darklyght/RISC-V-on-Zynq-7000/spec/defines.tex

\newcommand{\currentSemester}{Fall 2019}
\newcommand{\projectSpecVersion}{4.3}

\newcommand{\dueDateTime}{end of lab sessions}

\newcommand{\blockDiagramTaskName}{Checkpoint 1}
\newcommand{\blockDiagramDueDate}{November 1}
\newcommand{\blockDiagramTimeAlloted}{1 week}

\newcommand{\baseCPUTaskName}{Checkpoint 2}
\newcommand{\baseCPUDueDate}{November 22}
\newcommand{\baseCPUTimeAlloted}{3 weeks}

\newcommand{\audioTaskName}{Checkpoint 3}
\newcommand{\audioDueDate}{December 9}
\newcommand{\audioTimeAlloted}{2 weeks}

\newcommand{\dfsTaskName}{Checkpoint 4}
\newcommand{\dfsDueDate}{December 6}
\newcommand{\dfsTimeAlloted}{2 weeks}

\newcommand{\finalCheckoffDueDate}{December 9 (by appointment)}

\newcommand{\finalReportDueDate}{December 11}

\newcommand{\skeletonRepoName}{project\_skeleton\_fa19}
\newcommand{\semesterName}{fa19}

%Also, change the info in minted blocks.  This includes the "Setting up your Code Repository" section and the "Setting up the Vivado Project" section
