darklyght/RISC-V-on-Zynq-7000/spec/project_spec.tex

\documentclass[11pt]{article}
\usepackage{fullpage}
\usepackage{verbatim}
\usepackage{moreverb}
\usepackage{amsmath}
\let\verbatiminput=\verbatimtabinput
\def\verbatimtabsize{4\relax}
\usepackage{tikz}
\usetikzlibrary{arrows,automata, positioning}
\usepackage{array}
\usepackage{booktabs}
\usepackage{minted}
\usepackage{parskip}
\usepackage{float}
\usepackage{pbox}
\usepackage{makecell}
\usepackage{gensymb}
\graphicspath{{images/}}

\usepackage{color}
\definecolor{rltred}{rgb}{0.75,0,0}
\definecolor{rltgreen}{rgb}{0,0.5,0}
\definecolor{rltblue}{rgb}{0,0,0.75}

\usepackage[%pdftex,
    colorlinks=true,
    urlcolor=rltblue,               % \href{...}{...}
    anchorcolor=rltbrightblue,
    filecolor=rltgreen,             % \href*{...}
    linkcolor=rltred,               % \ref{...} and \pageref{...}
    menucolor=webdarkblue,
    citecolor=webbrightgreen,
    pagebackref,
    pdfpagemode=UseNone,
    bookmarksopen=true]{hyperref}
\usepackage{graphicx}
\usepackage{hyperref}

\newcommand{\instbit}[1]{\mbox{\scriptsize #1}}
\newcommand{\instbitrange}[2]{~\instbit{#1} \hfill \instbit{#2}~}

\input{defines.tex}

\begin{document}
\begin{center}
{\bf
University of California at Berkeley \\
College of Engineering \\
Department of Electrical Engineering and Computer Science \\
}
\end{center}

\begin{center}
EECS151/251A - LB, \currentSemester
\end{center}

\begin{center}
\LARGE
{\bf Project Specification: RISCV151 }  \\
Version \projectSpecVersion
\end{center}

\tableofcontents

\newpage

\section{Introduction}
The goal of this project is to familiarize EECS151/251A students with the methods and tools of digital design.
In teams of 2, you will design and implement a 3-stage pipelined RISC-V CPU with a UART for tethering.
Afterwards, you will attach the IO circuits you built in the lab to the CPU and design a subtractive audio synthesizer.
Then, you will implement a simple dynamic frequency scaling algorithm to bound the power consumption and temperature of your FPGA design while achieving a performance target.
Finally, you will optimize your CPU for performance (maximizing the Iron Law) and cost (FPGA resource utilization).

You will use Verilog to implement this system, targeting the Xilinx Pynq platform (a Pynq-Z1 development board with a Zynq 7000-series FPGA).
The project will give you experience designing with RTL descriptions, resolving hazards in a simple pipeline, building interfaces, and teach you how to approach system-level optimization.

In tackling these challenges, your first step will be to map the high level specification to a design which can be translated into a hardware implementation.
After that, you will produce and debug that implementation.
These first steps can take significant time if you have not thought out your design prior to trying implementation.

As in previous semesters, your EECS151/251A project is probably the largest project you have faced so far here at Berkeley.
Good time management and good design organization is critical to your success.

\subsection{Tentative Deadlines}
\label{tentative_deadlines}
The following is a brief description of each checkpoint and approximately how many weeks will be alloted to each one. This schedule may change as the semester progresses. The current schedule is summarised at the end of the document in Section \ref{project_timeline}.

\begin{itemize}
  \item \textbf{\blockDiagramDueDate \space - \blockDiagramTaskName \space (\blockDiagramTimeAlloted)} - Draw a schematic of your processor's datapath and pipeline stages.
  \item \textbf{\baseCPUDueDate \space - \baseCPUTaskName \space (\baseCPUTimeAlloted)} - Implement your RISC-V processor core in Verilog and write tests to verify your implementation.
  \item \textbf{\audioDueDate \space - \audioTaskName \space (\audioTimeAlloted)} - Attach I/O components from lab to your processor (FIFOs, buttons, switches), general PWM controller, basic subtractive synthesizer
  %\item \textbf{\dfsDueDate \space - \dfsTaskName \space (\dfsTimeAlloted)} - Implement a dedicated power management unit to monitor FPGA temperature and power consumption and dynamically switch the operating frequency of the main CPU.
  \item \textbf{\finalCheckoffDueDate \space - Final Checkoff} - Final processor optimization and checkoff
  \item \textbf{\finalReportDueDate \space - Project Report} - Final report due
\end{itemize}

\subsection{General Project Tips}
\label{tips}
Document your project as you go.
You should comment your Verilog and keep your diagrams up to date.
Aside from the final project report (you will need to turn in a report documenting your project), you can use your design documents to help the debugging process.

Finish the required features first.
Attempt extra features after everything works well.
\textbf{If your submitted project does not work by the final deadline, you will not get any credit for any extra credit features you have implemented.}

This project, as has been done in past semesters, will be divided into checkpoints. The following sections will specify the objectives for each checkpoint.

\section{Checkpoints 1 \& 2 - 3-stage Pipelined RISC-V CPU}
The first checkpoint in this project is designed to guide the development of a three-stage pipelined RISC-V CPU that will be used as a base system in subsequent checkpoints.

\begin{figure}[hbt]
\begin{center}
  
  \caption{High-level overview of the full system}
  \label{fig:sys_overview}
\end{center}
\end{figure}

The green (RISC-V core) block on the diagram is the focus of the first and second checkpoints.
The third checkpoint will add audio and IO components in blue.
Finally, the fourth checkpoint will implement the power management unit in red.

\subsection{Setting up your Code Repository}
The project skeleton files are available on Github.
The suggested way for initializing your repository with the skeleton files is as follows:

\begin{minted}[tabsize=2]{bash}
  git clone git@github.com:EECS150/project_skeleton_fa19.git
  cd project_skeleton_fa19
  git remote add my-repo git@github.com:EECS150/fa19_teamXX.git
  git push my-repo master
\end{minted}

Then reclone your repo and add the skeleton repo as a remote:
\begin{minted}[tabsize=2]{bash}
  cd ..
  rm -rf project_skeleton_fa19
  git clone git@github.com:EECS150/fa19_teamXX.git
  cd fa19_teamXX
  git remote add staff git@github.com:EECS150/project_skeleton_fa19.git
\end{minted}

To pull project updates from the skeleton repo, run \verb|git pull staff master|.

To get a team repo, fill one line in the Google spreadsheet posted on Piazza with your team information (names, Github logins, and enrolled lab session).

You should check frequently for updates to the skeleton files.
Update announcements will be posted to Piazza.

\subsection{Integrate Designs from Labs} \label{past_designs}
You should copy some modules you designed from the labs.
We suggest you keep these with the provided source files in \verb|hardware/src| (overwriting any provided skeletons).

\begin{minted}[tabsize=2]{bash}
  cd fa19_teamXX
  cp fpga_labs_fa19/lab6/debouncer.v fa19_teamXX/hardware/src/io_circuits/.
\end{minted}

\textbf{Copy these files from the labs:}
\begin{minted}{bash}
  lab6/debouncer.v
  lab6/synchronizer.v
  lab6/edge_detector.v
  lab6/fifo.v
  lab6/uart_transmitter.v
\end{minted}

\subsection{Project Skeleton Overview}
\begin{itemize}
  \item \texttt{hardware}
    \begin{itemize}
      \item \texttt{src}
        \begin{itemize}
          \item \texttt{z1top.v}: Top level module. The RISC-V CPU is instantiated here.
          \item \texttt{PYNQ-Z1.xdc}: Constraints file. You can modify this to change pin assignments for peripherals when connecting I/O.
          \item \texttt{riscv\_core/Riscv151.v}: All of your CPU datapath and control should be contained in this file.
          \item \texttt{riscv\_core/reg\_file.v}: Your register file implementation.
          \item \verb|memories/{imem, dmem, bios_mem}.v|: Synthesizable RAMs for the instruction, data, and BIOS memories.
          \item \verb|io_circuits/uart.v, uart_transmitter.v, uart_receiver.v|: Your working UART from Labs 5 and 6
        \end{itemize}
      \item \texttt{sim}
        \begin{itemize}
          \item \verb|assembly_testbench.v|: Starting point for testing your CPU. Works with the software in \texttt{assembly\_tests}.
          \item \verb|echo_testbench.v|: Runs the software in \texttt{echo} on your CPU. The software implements the echo FSM from lab 5, and the testbench controls an off-chip UART to test it.
        \end{itemize}
    \end{itemize}
  \item \texttt{software}
    \begin{itemize}
      \item \verb|bios151v3|: The BIOS program, which allows us to interact with our CPU via the UART. You need to compile it before creating a bitstream or running a simulation.
      \item \verb|echo|: The echo program, which emulates the FSM from Lab 5 in software.
      \item \verb|assembly_tests|: Use this as a template to write assembly tests for your processor designed to run in simulation.
      \item \verb|c_example|: Use this as an example to write C programs.
      \item \verb|mmult|: This is a program to be run on the FPGA for Checkpoint 2. It generates 2 matrices and multiplies them. Then it returns a checksum to verify the correct result.
    \end{itemize}
\end{itemize}

To compile \texttt{software} go into a program directory and run \texttt{make}.
To build a bitstream run \texttt{make impl} in \texttt{hardware}.

\subsection{RISC-V 151 ISA}
Table \ref{tab:ISA} contains all of the instructions your processor is responsible for supporting.
It contains most of the instructions specified in the RV32I Base Instruction set, and allows us to maintain a relatively simple design while still being able to have a C compiler and write interesting programs to run on the processor.
For the specific details of each instruction, refer to sections 2.2 through 2.6 in the \href{http://riscv.org/specifications/}{RISC-V Instruction Set Manual}.

\subsubsection{CSR Instructions}
You will have to implement 2 CSR instructions to support running the standard RISC-V ISA test suite.
A CSR (or control status register) is some state that is stored independent of the register file and the memory.
While there are $2^{12}$ possible CSR addresses, you will only use one of them (\texttt{tohost = 0x51E}).
The \texttt{tohost} register is monitored by the RISC-V ISA testbench (\verb|isa_testbench.v|), and simulation ends when a non-zero value is written to this register.
A CSR value of 1 indicates success, and a value greater than 1 indicates which test failed.

There are 2 CSR related instructions that you will need to implement:
\begin{enumerate}
  \item \texttt{csrw tohost,x2}  (short for \texttt{csrrw x0,csr,rs1} where \texttt{csr = 0x51E})
  \item \texttt{csrwi tohost,1}  (short for \texttt{csrrwi x0,csr,uimm} where \texttt{csr = 0x51E})
\end{enumerate}

\texttt{csrw} will write the value from \texttt{rs1} into the addressed CSR.
\texttt{csrwi} will write the immediate (stored in the rs1 field in the instruction) into the addressed CSR.
Note that you do not need to write to \texttt{rd} (writing to x0 does nothing), since the CSR instructions are only used in simulation.

\input{isa.tex}

\subsection{Pipelining}
Your CPU must implement this instruction set using a 3-stage pipeline.
The division of the datapath into three stages is left unspecified as it is an important design decision with significant performance implications.
We recommend that you begin the design process by considering which elements of the datapath are synchronous and in what order they need to be placed.
After determining the design blocks that require a clock edge, consider where to place asynchronous blocks to minimise the critical path.
The RAMs we are using for the data, instruction, and BIOS memories are both synchronous read \textbf{and} write.

\subsection{Hazards}
As you have learned in lecture, pipelines create hazards.
Your design will have to resolve both control and data hazards.
You must resolve data hazards by implementing forwarding whenever possible.
This means that you must forward data from your data memory instead of stalling your pipeline or injecting NOPs.
All data hazards can be resolved by forwarding in a three-stage pipeline.

You'll have to deal with the following types of hazards:
\begin{enumerate}
  \item \textbf{Read-after-write data hazards} Consider carefully how to handle instructions that depend on a preceding load instruction, as well as those that depend on a previous arithmetic instruction.
  \item \textbf{Control hazards} What do you do when you encounter a branch instruction, a jal (jump and link), or jalr (jump from register and link)?
    You will have to choose whether to predict branches as taken or not taken by default and kill instructions that weren't supposed to execute if needed.
    You can begin by resolving branches by stalling the pipeline, and when your processor is functional, move to naive branch prediction.
\end{enumerate}

\subsection{Register File}
\label{reg_file}
Your register file should have two asynchronous-read ports and one synchronous-write port (positive edge).

To test your register file, you should write a testbench to verify the following:
\begin{itemize}
  \item Register 0 is not writable, i.e. reading from register 0 always returns 0
  \item Registers are updated on the same cycle that a write occurs (i.e. the value read on the cycle following the rising edge of the write should be the value written).
  \item The write enable signal to the register file controls whether a write occurs (\verb|we| is active high, meaning you only write when \verb|we| is high)
  \item Reads should be asynchronous (the value at the output one simulation timestep (\#1) after feeding in an input address should be the value stored in that register)
\end{itemize}

\subsection{RAMs}
\label{ram_info}
In this project, we will be using inferred block RAMs to implement memories for the processor.

\subsubsection{Initialization}
The Verilog \verb|$readmemb(filename, path to 2D reg, start addr, end addr)| and \verb|$readmemh()| system tasks can be used to initialize a 2D reg with a text file containing the desired contents of the memory (in binary or hex respectively).
These system tasks are placed inside an \verb|initial| block and point to a particular 2D reg instance to initialize.
If a 2D reg isn't initialized it is filled with Xs.

For synthesis, the BIOS memory is initialized with the contents of the BIOS program, and the other memories are left uninitialized (zeroed out)\\
(see \verb|src/memories/{imem, dmem, bios_mem}.v|).

For simulation, the provided testbenches initialize the BIOS memory with a program specified by the testbench (see \verb|sim/assembly_testbench.v|).

\subsubsection{Endianness + Addressing}
The instruction and data RAMs have 16384 32-bit rows, as such, they accept 14 bit addresses.
The RAMs are \textbf{word-addressed}; this means that every unique 14 bit address refers to one 32-bit row (word) of memory.

However, the memory addressing scheme of RISC-V is \textbf{byte-addressed}.
This means that every unique 32 bit address the processor computes (in the ALU) points to one 8-bit byte of memory.

We consider the bottom 16 bits of the computed address (from the ALU) when accessing the RAMs.
The top 14 bits are the word address (for indexing into one row of the block RAM), and the bottom two are the byte offset (for indexing to a particular byte in a 32 bit row).

\label{endianness}
\begin{figure}[H]
  \begin{center}
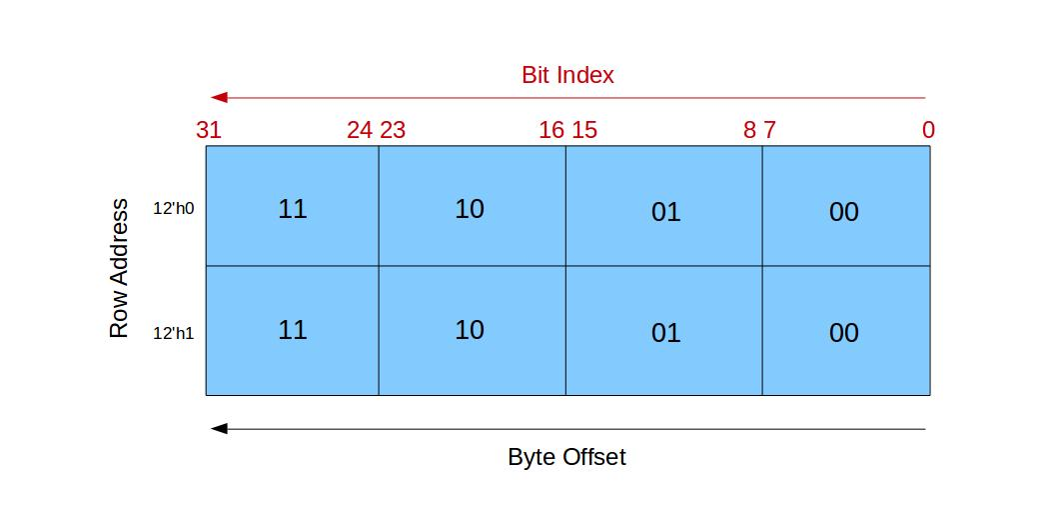
[picture p1: spec/images/endianness_img.jpg]
    
    \caption{Block RAM organization. The labels for row address \textbf{should read 14'h0 and 14'h1.}}
    \label{fig:endianness_img}
  \end{center}
\end{figure}

Figure \ref{fig:endianness_img} illustrates the 14-bit word addresses and the two bit byte offsets.
Observe that the RAM organization is \textbf{little-endian}, i.e. the most significant byte is at the most significant memory address (offset '11').

\subsubsection{Reading from RAMs}
Since the RAMs have 32-bit rows, you can only read data out of the RAM 32-bits at a time.
This is an issue when executing an \verb|lh| or \verb|lb| instruction, as there is no way to indicate which 8 or 16 of the 32 bits you want to read out.

Therefore, you will have to shift and mask the output of the RAM to select the appropriate portion of the 32-bits you read out.
For example, if you want to execute a \verb|lbu| on a byte address ending in \verb|2'b10|, you will only want bits \verb|[23:16]| of the 32 bits that you read out of the RAM (thus storing \verb|{24'b0, output[23:16]}| to a register).

\subsubsection{Writing to RAMs}
To take care of \verb|sb| and \verb|sh|, note that the \verb|we| input to the instruction and data memories is 4 bits wide.
These 4 bits are a byte mask telling the RAM which of the 4 bytes to actually write to.
If \verb|we|=\{4'b1111\}, then all 32 bits passed into the RAM would be written to the address given.

Here's an example of storing a single byte:
\begin{itemize}
  \item Write the byte \verb|0xa4| to address \verb|0x10000002| (byte offset = 2)
  \item Set \verb|we = {4'b0100}|
  \item Set \verb|din = {32'hxx_a4_xx_xx}| (\verb|x| means don't care)
\end{itemize}

\subsection{Memory Architecture}
The standard RISC pipeline is usually depicted with separate instruction and data memories.
Although this is an intuitive representation, it does not let us modify the instruction memory to run new programs.
Your CPU, by the end of this checkpoint, will be able to receive compiled RISC-V binaries though the UART, store them into instruction memory, then jump to the downloaded program.
To facilitate this, we will adopt a modified memory architecture shown in Figure \ref{fig:mem_arch}.

\begin{figure}[hbt]
  \begin{center}
    
    \caption{The Riscv151 memory architecture. There is only 1 IMEM and DMEM instance in Riscv151 but their ports are shown separately in this figure for clarity. The left half of the figure shows the instruction fetch logic and the right half shows the memory load/store logic.}
    \label{fig:mem_arch}
  \end{center}
\end{figure}

\subsubsection{Summary of Memory Access Patterns}
The memory architecture will consist of three RAMs (instruction, data, and BIOS).
The RAMs are memory resources (block RAMs) contained within the FPGA chip, and no external (off-chip, DRAM) memory will be used for this project.

The processor will begin execution from the BIOS memory, which will be initialized with the BIOS program (in \verb|software/bios151v3|).
The BIOS program should be able to read from the BIOS memory (to fetch static data and instructions), and read and write the instruction and data memories.
This allows the BIOS program to receive user programs over the UART from the host PC and load them into instruction memory.

You can then instruct the BIOS program to jump to an instruction memory address, which begins execution of the program that you loaded.
At any time, you can press the reset button on the board to return your processor to the BIOS program.

\subsubsection{Unaligned Memory Accesses}
In the official RISC-V specification, unaligned loads and stores are supported.
However, in your project, you can ignore instructions that request an unaligned access.
Assume that the compiler will never generate unaligned accesses.

\subsubsection{Address Space Partitioning}
Your CPU will need to be able to access multiple sources for data as well as control the destination of store instructions.
In order to do this, we will partition the 32-bit address space into four regions: data memory read and writes, instruction memory writes, BIOS memory reads, and memory-mapped I/O.
This will be encoded in the top nibble (4 bits) of the memory address generated in load and store operations, as shown in Table \ref{mem_space1}.
In other words, the target memory/device of a load or store instruction is dependent on the address.
The reset signal should reset the PC to the value defined by the parameter \verb|RESET_PC| which is by default the base of BIOS memory (\verb|0x40000000|).

\begin{table}[hbt]
  \begin{center}
    \caption{Memory Address Partitions}
    \label{mem_space1}
    \begin{tabular}{l l l l l}
      \bottomrule
      \textbf{Address[31:28]} & \textbf{Address Type} & \textbf{Device} & \textbf{Access} & \textbf{Notes} \\
      \midrule
      4'b00x1 & Data & Data Memory & Read/Write &\\
      4'b0001 & PC  &  Instruction Memory & Read-only &\\
      4'b001x & Data & Instruction Memory & Write-Only & Only if PC[30] == 1'b1\\
      4'b0100 & PC  & BIOS Memory & Read-only &\\
      4'b0100 & Data & BIOS Memory & Read-only &\\
      4'b1000 & Data & I/O & Read/Write &\\
      \bottomrule
    \end{tabular}
  \end{center}
\end{table}

Each partition specified in Table \ref{mem_space1} should be enabled based on its associated bit in the address encoding.
This allows operations to be applied to multiple devices simultaneously, which will be used to maintain memory consistency between the data and instruction memory.

For example, a store to an address beginning with \verb|0x3| will write to both the instruction memory and data memory, while storing to addresses beginning with \verb|0x2| or \verb|0x1| will write to only the instruction or data memory, respectively.
For details about the BIOS and how to run programs on your CPU, see Section~\ref{bios_info}.

Please note that a given address could refer to a different memory depending on which address type it is.
For example the address \verb|0x10000000| refers to the data memory when it is a data address while a program counter value of \verb|0x10000000| refers to the instruction memory.

The note in the table above (referencing PC[30]), specifies that you can only write to instruction memory if you are currently executing in BIOS memory.
This prevents programs from being self-modifying, which would drastically complicate your processor.

\subsubsection{Memory Mapped I/O}
\label{mmio}
At this stage in the project the only way to interact with your CPU is through the UART.
The UART from Lab 5 accomplishes the low-level task of sending and receiving bits from the serial lines, but you will need a way for your CPU to send and receive bytes to and from the UART.
To accomplish this, we will use memory-mapped I/O, a technique in which registers of I/O devices are assigned memory addresses.
This enables load and store instructions to access the I/O devices as if they were memory.

To determine CPI (cycles per instruction) for a given program, the I/O memory map is also used to include instruction and cycle counters.

Table~\ref{mem_map1} shows the memory map for this stage of the project.

\begin{table}[hbt]
  \begin{center}
    \caption{I/O Memory Map}
    \label{mem_map1}
    \begin{tabular}{l l l l}
      \toprule
      \textbf{Address} & \textbf{Function} & \textbf{Access} & \textbf{Data Encoding}\\
      \midrule
      \verb|32'h80000000| & UART control & Read & \verb|{30'b0, data_out_valid, data_in_ready}| \\
      \verb|32'h80000004| & UART receiver data & Read & \verb|{24'b0, data_out}| \\
      \verb|32'h80000008| & UART transmitter data & Write & \verb|{24'b0, data_in}| \\
      \midrule
      \verb|32'h80000010| & Cycle counter & Read & Clock cycles elapsed \\
      \verb|32'h80000014| & Instruction counter & Read & Number of instructions executed \\
      \verb|32'h80000018| & Reset counters to 0 & Write & N/A \\
      \bottomrule
    \end{tabular}
  \end{center}
\end{table}

You will need to determine how to translate the memory map into the proper ready-valid handshake signals for the UART.
Your UART should respond to \verb|sw, sh, and sb| for the transmitter data address, and should also respond to \verb|lw, lh, lb, lhu, and lbu| for the receiver data and control addresses.

You should treat I/O such as the UART just as you would treat the data memory.
This means that you should assert the equivalent write enable (i.e. valid) and data signals at the end of the execute stage, and read in data during the memory stage.
The CPU itself should not check the \verb|data_out_valid| and \verb|data_in_ready| signals; this check is handled in software.
The CPU needs to drive \verb|data_out_ready| and \verb|data_in_valid| correctly.

The cycle counter should be incremented every cycle, and the instruction counter should be incremented for every instruction that is committed (you should not count bubbles injected into the pipeline or instructions run during a branch mispredict).
From these counts, the CPI of the processor can be determined for a given benchmark program.

\subsection{Testing}
\label{testing}
The design specified for this project is a complex system and debugging can be very difficult without tests that increase visibility of certain areas of the design.
In assigning partial credit at the end for incomplete projects, we will look at testing as an indicator of progress.
A reasonable order in which to complete your testing is as follows:

\begin{enumerate}
  \item Test that your modules work in isolation via Verilog testbenches
  \item Test the entire CPU one instruction at a time with hand-written assembly --- see \verb|assembly_testbench.v|
  \item Test the CPU's memory mapped I/O --- see \verb|echo_testbench.v|
  \item Run the \verb|riscv-tests| ISA test suite
\end{enumerate}

\subsubsection{Integration Testing}
Once you are confident that the individual components of your processor are working in isolation, you will want to test the entire processor as a whole. The easiest way to do this is to write an assembly program that tests all of the instructions in your ISA.
A skeleton is provided for you in \verb|software/assembly_tests|.
See Section \ref{assembly_tests} for details.

Once you have verified that all the instructions in the ISA are working correctly, you may also want to verify that the memory mapped I/O and instruction/data memory reading/writing work with a similar assembly program.

\subsection{Software Toolchain - Writing RISC-V Programs}
\label{toolchain}
A GCC RISC-V toolchain has been built and installed in the eecs151 home directory; these binaries will run on any of the c125m machines in the 125 Cory lab.
The most relevant programs in the toolchain are:
\begin{itemize}
    \item \verb|riscv64-unknown-elf-gcc|: GCC for RISC-V, compiles C code to RISC-V binaries.
    \item \verb|riscv64-unknown-elf-as|: RISC-V assembler, compiles assembly code to RISC-V binaries.
    \item \verb|riscv64-unknown-elf-objdump|: Dumps RISC-V binaries as readable assembly code.
\end{itemize}

Look at the \verb|software/c_example| folder for an example of a C program.

There are several files:
\begin{itemize}
    \item \verb|start.s|: This is an assembly file that contains the start of the program.
      It initialises the stack pointer then jumps to the \verb|main| label.
      Edit this file to move the top of the stack.
      Typically your stack pointer is set to the top of the data memory address space, so that the stack has enough room to grow downwards.

    \item \verb|c_example.ld|: This linker script sets the base address of the program.
      For Checkpoint 2, this address should be in the format \verb|0x1000xxxx|
      The .text segment offset is typically set to the base of the instruction memory address space.

    \item \verb|c_example.elf|: Binary produced after running \verb|make|.\\Use \verb|riscv64-unknown-elf-objdump -Mnumeric -D c_example.elf| to view the assembly code.
    \item \verb|c_example.dump|: Assembly dump of the binary.
\end{itemize}

\subsection{Assembly Tests}
\label{assembly_tests}
Hand written assembly tests are in \verb|software/assembly_tests/start.s| and the corresponding testbench is in \verb|hardware/sim/assembly_testbench.v|.
To run the test, run:\\
\verb|make sim/assembly_testbench.fst| (iverilog) or \verb|make sim/assembly_testbench.vpd| (VCS).

If you want to forcibly re-run the test even though you didn't change the Verilog, run:\\
\verb|make -B sim/assembly_testbench.fst|

\verb|start.s| contains assembly that's compiled and loaded into the BIOS RAM by the testbench.
\begin{minted}[breaklines]{asm}
_start:

# Test ADD
li x10, 100         # Load argument 1 (rs1)
li x11, 200         # Load argument 2 (rs2)
add x1, x10, x11    # Execute the instruction being tested
li x20, 1           # Set the flag register to stop execution and inspect the result register
                    # Now we check that x1 contains 300 in the testbench

Done: j Done
\end{minted}

The \verb|assembly_testbench| toggles the clock one cycle at time and waits for register \verb|x20| to be written with a particular value (in the above example: 1).
Once \verb|x20| contains 1, the testbench inspects the value in \verb|x1| and checks it is 300, which indicates your processor correctly executed the add instruction.

If the testbench times out it means \verb|x20| never became 1, so the processor got stuck somewhere or \verb|x20| was written with another value.

\subsection{RISC-V ISA Tests}
You will need the CSR instructions to work before you can use this test suite, and you should have confidence in your hand-written assembly tests.
Test the CSR instructions using hand assembly tests.

To run the ISA tests, first pull the latest skeleton changes:
\begin{minted}{bash}
git pull staff master
git submodule update --init --recursive
\end{minted}

Modify line 4 of \verb|sim/isa_testbench.v| to point to the tohost CSR register in your CPU.
Then run:

\begin{minted}{bash}
cd software/riscv-isa-tests
make
cd hardware
make isa-tests
\end{minted}

The output of each test (a .log file and a .fst waveform) is stored in \verb|hardware/sim/isa|.
To re-run a particular ISA test (e.g. \verb|add|) run \verb|make sim/isa/add.fst|.

To check what tests passed run \texttt{cat sim/isa/*.log | grep -i pass}.
To check for failures run \texttt{cat sim/isa/*.log | grep -i fail}.

You can expect the \verb|fence_i| test to fail, but the rest should pass.
If you're failing other tests, debug using the test assembly file in\\\verb|software/riscv-isa-tests/riscv-tests/isa/rv32ui| or the generated assembly dump.

The \verb|RESET_PC| parameter is used in \verb|isa_testbench| to start the test in the IMEM instead of the BIOS.
Make sure you have used it in \verb|Riscv151.v|.

\subsection{BIOS and Programming your CPU}
\label{bios_info}

We have provided a BIOS program in \verb|software/bios151v3| that allows you to interact with your CPU and download other programs over UART.
The BIOS is just an infinite loop that reads from the UART, checks if the input string matches a known control sequence, and then performs an associated action.
For detailed information on the BIOS, see Appendix \ref{sec:biosinfo}.

To run the BIOS:
\begin{enumerate}
  \item Verify that the stack pointer and .text segment offset are set properly in \verb|start.s| and \verb|bios151v3.ld|
  \item Compile the program with \verb|make| in the \verb|software/bios151v3| directory
  \item Verify the \verb|bios_mem.v| module is initialized with the BIOS hex file
  \item Build a bitstream and program the FPGA
  \item Use screen to access the serial port:
    \begin{minted}[tabsize=2]{bash}
    screen $SERIALTTY 115200
    \end{minted}
  \item Press the reset button to make the CPU PC go to the start of BIOS memory
\end{enumerate}

Close screen using \verb|Ctrl-a Shift-k|, or other students won't be able to use the serial port!
If you can't access the serial port you can run \verb|killscreen| to kill all screen sessions.

If all goes well, you should see a \verb|151 >| prompt after pressing return. The following commands are available:
\begin{itemize}
    \item \verb|jal <address>|: Jump to address (hex).
    \item \verb|sw, sb, sh <data> <address>|: Store data (hex) to address (hex).
    \item \verb|lw, lbu, lhu <address>|: Prints the data at the address (hex).
\end{itemize}

As an example, running \verb|sw cafef00d 10000000| should write to the data memory and running \verb|lw 10000000| should print the output \verb|10000000: cafef00d|.
Please also pay attention that writes to the instruction memory (\verb|sw ffffffff 20000000|) do not write to the data memory, i.e. \verb|lw 10000000| still should yield \verb|cafef00d|.

In addition to the command interface, the BIOS allows you to load programs to the CPU. \textit{With screen closed}, run:
\begin{minted}[tabsize=2]{bash}
    hex_to_serial <hex_file> <address>
\end{minted}

This stores the \verb|.hex| file at the specified hex address.
In order to write into both the data and instruction memories, \textbf{remember to set the top nibble to 0x3} (i.e. \verb|hex_to_serial echo.hex 30000000|, assuming the \verb|.ld| file sets the base address to \verb|0x10000000|).

You also need to ensure that the stack and base address are set properly (See Section \ref{toolchain}).
For example, before making the \verb|mmult| program you should set the set the base address to \verb|0x10000000| (see \ref{mmult}).
Therefore, when loading the \verb|mmult| program you should load it at the base address: \verb|hex_to_serial mmult.hex 30000000|.
Then, you can jump to the loaded \verb|mmult| program in in your screen session by using \verb|jal 10000000|.

\subsection{Target Clock Frequency}
By default, the CPU clock frequency is set at 50MHz.
It should be easy to meet timing at 50 MHz.
Look at the reports in \verb|hardware/build/synth/post_synth_timing_summary.rpt| and \verb|impl/post_route_timing_summary.rpt| to see if timing is met.
If you failed, the timing reports specify the critical path you should optimize.

For this checkpoint, we will allow you to demonstrate the CPU working at 50 MHz, but for the final checkoff at the end of the semester, you will need to optimize for a higher clock speed ($\geq$ 100MHz) for full credit.
Details on how to build your FPGA design with a different clock frequency will come later.

\subsection{Matrix Multiply}
\label{mmult}
To check the correctness and performance of your processor we have provided a benchmark in \verb|software/mmult/| which performs matrix multiplication.
You should be able to load it into your processor in the same way as loading the echo program.

This program computes $S=AB$, where $A$ and $B$ are 64$\times$64 matrices.
The program will print a checksum and the counters discussed in Section ~\ref{mmio}.
The correct checksum is \verb|0001f800|.
If you do not get this, there is likely a problem in your CPU with one of the instructions that is used by the BIOS but not mmult.

The matrix multiply program requires that the stack pointer and the offset of the .text segment be set properly, otherwise the program will not execute properly.

The stack pointer (set in \verb|start.s|) should start near the top of DMEM to avoid corrupting the program instructions and data.
It should be set to \verb|0x1000fff0| and the stack grows downwards.

The .text segment offset (set in \verb|mmult.ld|) needs to accommodate the full set of instructions and static data (three 64$\times$64 matrices) in the mmult binary.
It should be set to the base of DMEM: \verb|0x10000000|.

The program will also output the values of your instruction and cycle counters (in hex).
These can be used to calculate the CPI for this program.
Your target CPI should be under 1.2.
If your CPI exceeds this value, you will need to modify your datapath and pipeline to reduce the number of bubbles inserted for resolving control hazards (since they are the only source of extra latency in our processor).
This might involve performing naive branch prediction or moving the jalr address calculation to an earlier stage.

\subsection{How to Survive This Checkpoint}
Start early and work on your design incrementally.
Draw up a very detailed and organised block diagram and keep it up to date as you begin writing Verilog.
Unit test independent modules such as the control unit, ALU, and regfile.
Write thorough and complex assembly tests by hand, and don't solely rely on the RISC-V ISA test suite.
The final BIOS program is several 1000 lines of assembly and will be nearly impossible to debug by just looking at the waveform.

The most valuable asset for this checkpoint will not be your GSIs but will be your fellow peers who you can compare notes with and discuss design aspects with in detail.
However, do NOT under any circumstances share source code.

Once you're tired, go home and \textit{sleep}. When you come back you will know how to solve your problem.

\subsubsection{How To Get Started}
It might seem overwhelming to implement all the functionality that your processor must support. The best way to implement your processor is in small increments, checking the correctness of your processor at each step along the way. Here is a guide that should help you plan out Checkpoint 1 and 2:

\begin{enumerate}
  \item \textit{Design.} You should start with a comprehensive and detailed design/schematic. Enumerate all the control signals that you will need. Be careful when designing the memory fetch stage since all the memories we use (BIOS, instruction, data, IO) are synchronous.
  \item \textit{First steps.} Implementing some modules that are easy to write and test. Write the \verb|reg_file.v| module. Create a Verilog testbench and test the cases in Section \ref{reg_file}.
  \item \textit{Control Unit + other small modules.} Implement the control unit, ALU, and any other small independent modules. Unit test them.
  \item \textit{Memory.} In the beginning, only use the BIOS memory in the instruction fetch stage and only use the data memory in the memory stage. This is enough to run assembly tests.
  \item \textit{Connect stages and pipeline.} Connect your modules together and pipeline them. At this point, you should be able to run integration tests using assembly tests for most R and I type instructions.
  \item \textit{Implement handling of control hazards.} Insert bubbles into your pipeline to resolve control hazards associated with JAL, JALR, and branch instructions. Don't worry about data hazard handling for now. Test that control instructions work properly with assembly tests.
  \item \textit{Implement data forwarding for data hazards.} Add forwarding muxes and forward the outputs of the ALU and memory stage. Remember that you might have to forward to ALU input A, ALU input B, and data to write to memory. Test forwarding aggressively; most of your bugs will come from incomplete or faulty forwarding logic. Test forwarding from memory and from the ALU, and with control instructions.
  \item \textit{Add BIOS memory reads.} Add the BIOS memory block RAM to the memory stage to be able to load data from the BIOS memory. Write assembly tests that contain some static data stored in the BIOS memory and verify that you can read that data.
  \item \textit{Add Inst memory writes and reads.} Add the instruction memory block RAM to the memory stage to be able to write data to it when executing inside the BIOS memory. Also add the instruction memory block RAM to the instruction fetch stage to be able to read instructions from the inst memory. Write tests that first write instructions to the instruction memory, and then jump (using jalr) to instruction memory to see that the right instructions are executed.
  \item \textit{Add cycle counters.} Begin to add the memory mapped IO components, by first adding the cycle and instruction counters. These are just 2 32-bit registers that your CPU should update on every cycle and every instruction respectively. Write tests to verify that your counters can be reset with a \verb|sw| instruction, and can be read from using a \verb|lw| instruction.
  \item \textit{Integrate UART.} Add the UART to the memory stage, in parallel with the data, instruction, and BIOS memories. Detect when an instruction is accessing the UART and route the data to the UART accordingly. Make sure that you are setting the UART ready/valid control signals properly as you are feeding or retrieving data from it. We have provided you with the \verb|echo_testbench| which performs a test of the UART.
  \item \textit{Run the BIOS.} If everything so far has gone well, program the FPGA. Verify that the BIOS performs as expected. As a precursor to this step, you might try to build a bitstream with the BIOS memory initialized with the echo program.
  \item \textit{Run matrix multiply.} Load the \verb|mmult| program with the \verb|hex_to_serial| utility, and run \verb|mmult| on the FPGA. Verify that it returns the correct checksum.
  \item \textit{Check CPI.} Compute the CPI when running the \verb|mmult| program. If you achieve a CPI below 1.2, that is acceptable, but if your CPI is larger than that, you should think of ways to reduce it.
\end{enumerate}

\subsection{Checkoff}
The checkoff is divided into two stages: block diagram/design and implementation.
The second part will require significantly more time and effort than the first one.
As such, completing the block diagram in time for the design review is crucial to your success in this project.

\subsubsection{\blockDiagramTaskName: Block Diagram}
The first checkpoint requires a detailed block diagram of your datapath.
The diagram should have a greater level of detail than a high level RISC datapath diagram.
You may complete this electronically or by hand.

If working by hand, we recommend working in pencil and combining several sheets of paper for a larger workspace.
If doing it electronically, you can use Inkscape, Google Drawings, draw.io or any program you want.

You should be able to describe in detail any smaller sub-blocks in your diagram.
Though the textbook diagrams are a decent starting place, remember that they often use asynchronous-read RAMs for the instruction and data memories, and we will be using synchronous-read block RAMs.
Additionally, at this point we recommend that you have completely functional UART, ALU, instruction decoder, and register file modules (see Section \ref{reg_file}).

\textbf{\blockDiagramTaskName \space is due in lab no later than \blockDiagramDueDate}.
You are required to go over your design with a GSI during lab.
Be prepared to talk generally about how you came up with your design and defend your design decisions.

\subsubsection{Non-Checkpoint Weeks}
GSIs will be in lab during the regular times to help you.
Come to lab every week even if there is no checkoff deadline.

\subsubsection{\baseCPUTaskName: Base RISCV151 System}
This checkpoint requires a fully functioning three stage RISC-V CPU as described in this specification.
Checkoff will consist of a demonstration of the BIOS functionality, loading a program (\verb|echo| and \verb|mmult|) over the UART, and successfully jumping to and executing the program.

\textbf{\baseCPUTaskName \space materials should be committed to your project repository by \baseCPUDueDate.}

\subsubsection{Checkpoints 1 \& 2 Deliverables Summary}
\begin{center}
  \begin{tabular}{m{30mm} m{35mm} m{70mm}}
    \toprule
    \textbf{Deliverable} & \textbf{Due Date} & \textbf{Description} \\
    \midrule
    Block Diagram & \blockDiagramDueDate & Sit down with a GSI and go over your design in detail\\
    \midrule
    RISC-V CPU & \baseCPUDueDate \linebreak Check in code to Github & Demonstrate that the BIOS works, you can use \verb|hex_to_serial| to load the \verb|echo| program, \verb|jal| to it from the BIOS, and have that program successfully execute. Load the mmult program with \verb|hex_to_serial|, \verb|jal| to it, and have it execute successfully and return the benchmarking results and correct checksum. Your CPI should be under 1.2\\
    \bottomrule
  \end{tabular}
\end{center}

\pagebreak

\section{Checkpoint 3 - I/O Integration, PWM Controller, Subtractive Synthesizer}
In checkpoint 3 of this project you will implement a memory mapped I/O interface to user inputs and outputs (buttons, LEDs, and switches).
To buffer user inputs to your processor you will integrate the FIFO you built in lab.

You will design a generic PWM controller that will function as a digital-to-analog converter (DAC) that drives the audio output jack.
Finally, you will implement a simple polyphonic subtractive synthesizer with a numerically controlled oscillator, a digital filter, and an amplitude envelope.

\subsection{I/O Integration}
In lab, you built a synchronizer, debouncer and an edge detector that were used to take in various user inputs.
Now, we want our processor to have access to these inputs (and the switches) and also to be able to drive outputs such as the LEDs.
We will extend our memory map to give programs access to these I/Os.

When a user pushes a button on the Pynq-Z1 board, the button's signal travels through the synchroniser $\rightarrow$ debouncer $\rightarrow$ edge detector chain.
The result is a single clock cycle wide pulse coming out of the edge detector that represents a single button press.
If we just extended our memory map to directly include the outputs from the edge detector, the processor would have to read from those locations on every clock cycle to be sure it didn't miss any user inputs.

To fix this, we will buffer user inputs with a FIFO and let the processor consume them when it has time to do so.

\subsubsection{Hookup User I/O}
We want to give the processor access to these I/Os:

\begin{itemize}
  \item Switches
  \item GPIO LEDs (the ones on the Pynq-Z1 board)
  \item Push-buttons
\end{itemize}

The I/O extension to the memory map is in Table \ref{mem_map2}.

\begin{table}[hbt]
  \begin{center}
    \caption{Memory Map for I/O Integration}
    \label{mem_map2}
    \begin{tabular}{l l l l}
      \toprule
      \textbf{Address} & \textbf{Function} & \textbf{Access} & \textbf{Data Encoding}\\
      \midrule
      \verb|32'h80000020| & GPIO FIFO Empty & Read & \verb|{31'd0, empty}| \\
      \verb|32'h80000024| & GPIO FIFO Read Data & Read & \verb|{29'd0, buttons[2:0]}| \\
      \midrule
      \verb|32'h80000028| & Switches & Read & \verb|{30'd0, SWITCHES[1:0]}| \\
      \midrule
      \verb|32'h80000030| & GPIO LEDs & Write & \verb|{26'd0, LEDS[5:0]}| \\
      \midrule
    \end{tabular}
  \end{center}
\end{table}

On any given clock cycle, when any of the button signals pulse high, the FIFO should be written to with the status of all the button signals.
The CPU should be able to read the empty signal of the FIFO, and it should be able to read out data from the FIFO with the FIFO's \verb|rd_en| signal controlled by your memory logic.

Modify \verb|z1top.v| and \verb|Riscv151.v| by instantiating your FIFO, hooking up its ports to the user I/O signals, and connecting your FIFO's read interface to the RISC-V core.

\subsubsection{User I/O Test Program}
The \verb|software/user_io_test| tests the FIFO and user I/O integration.
After programming the FPGA, run \verb|make| in the \verb|user_io_test| folder, and run \verb|hex_to_serial user_io_test.hex 30000000|.
Then \verb|screen| and \verb|jal 10000000| from the BIOS to jump into the user I/O test program.

This program has several commands to help you debug and verify functionality:
\begin{itemize}
  \item \verb|read_buttons| - CPU reads from the GPIO FIFO until it is empty, decodes the button press data, and prints it out.
  \item \verb|read_switches| - CPU reads the slide switches' address and prints out the state of the switches.
  \item \verb|led <data>| - Writes the \verb|<data>| (32-bits in hex) that you specify to the GPIO LEDs address. We only have 6 LEDs on the board so you can write values up to 0x3F.
  \item \verb|exit| - Jump back into BIOS.
\end{itemize}

\subsection{PWM DAC}
In lab we built a \verb|tone_generator| that took in a frequency and produced a square wave that drove the audio jack.
Now, we want to produce arbitrary waveforms so we can produce different types of sound.

To do this, we will design a PWM controller to function like a Digital-Analog-Converter (DAC).
Rather than feeding the \verb|tone_generator| a ``tone switch" period that describes a specific audio frequency, we will feed in a 12 bit number to a PWM controller that determines the duty cycle of the PWM output signal.
The 12 bit input to the PWM controller will determine the duty cycle according to the following equation:

\begin{equation*}
  \text{Duty Cycle} = \frac{\text{Input[11:0]}}{2^{12} - 1}
\end{equation*}

The Pynq board has a low pass filter attached to the output of \verb|aud_pwm| that will smooth the PWM waveform to an analog voltage:
\begin{center}
  
\end{center}

Note that there's no more notion of volume in this block (that will be handled in software).
We just want this block to act as a DAC.

\subsubsection{RISC-V Core Connection}
You'll have to memory map the input of this PWM block, but there's a catch.
In order to actually use this block as a proper DAC (especially for the next part), it will need to run very fast (much faster than your processor).
This implies that your PWM block will be running inside a different clock domain.

We dealt with clock domain crossings before (our synchronizer took an asynchronous signal and brought it into a synchronous domain).
However the single-bit synchronizer only works with 1-bit signals and not a 12-bit bus like the duty cycle input to the PWM controller.
We will implement a 4 phase handshake to make sure we reliably pass data from the RISC-V core's clock domain (TX/Transmit domain) to the PWM block's clock domain (RX/Receive domain).

A timing diagram is shown below:
\begin{center}
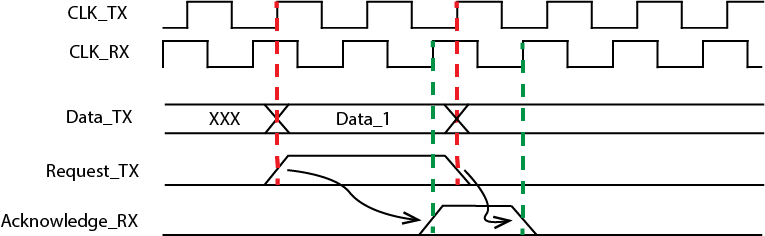
[picture p2: spec/images/ss_r_ack.png]
  
\end{center}

The four phase handshake uses four signals (\verb|req_tx|, \verb|req_rx|, \verb|ack_rx|, and \verb|ack_tx|).
\verb|req_rx| is the \verb|req_tx| signal synchronized into the RX domain, and \verb|ack_tx| is the \verb|ack_rx| signal synchronized into the TX domain.
requires the generation of two new synchronous signals, request and acknowledge, and the comparison of 4 edges.
\begin{enumerate}
  \item Request is asserted at the same time that the data is registered in the TX domain
  \item Acknowledge is asserted from the RX domain after the data has been captured in the RX domain (this could require holding the data for two clock cycles to ensure data coherency)
  \item Request is de-asserted in the TX domain
  \item Acknowledge is de-asserted in the RX domain and is then de-asserted in the TX domain
\end{enumerate}

Implement this with 2-flop synchronizers that synchronize the request and acknowledge signals between the clock domains.
A block diagram is shown below:

\begin{center}
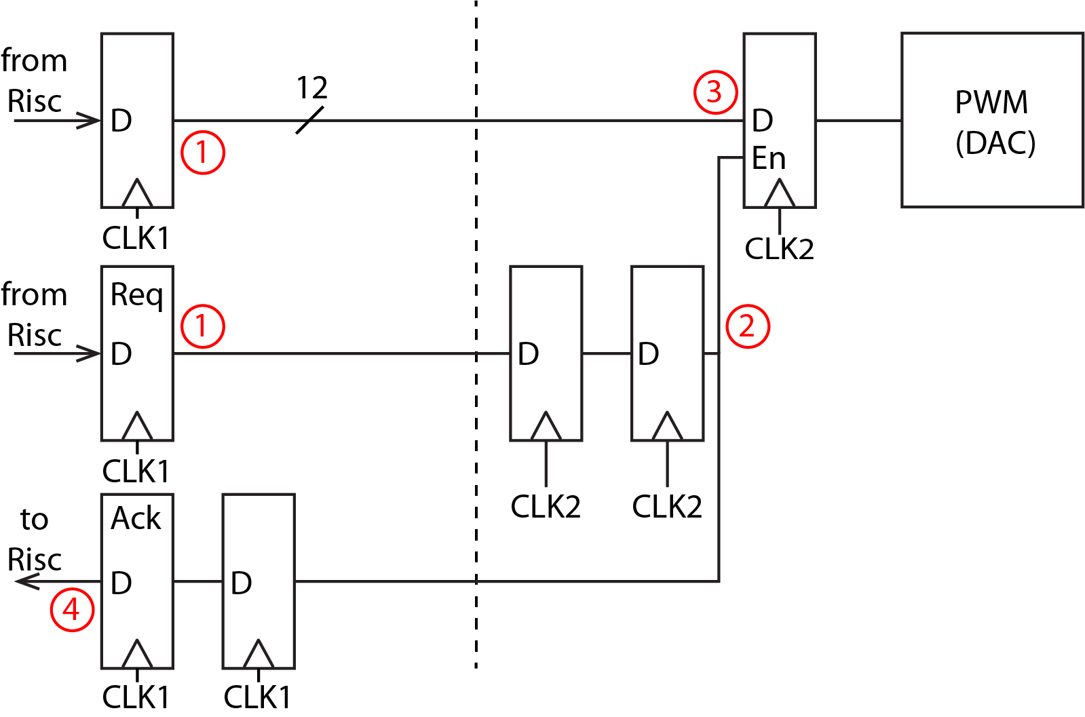
[picture p3: spec/images/fourPhase_1.png]
  
\end{center}

The numbers highlight the flow of data through the synchronizer circuit.
Here is a detailed sequence of steps to send data from the TX domain to the RX domain:
\begin{enumerate}
    \item First, the RISC-V core stores the duty cycle to the TX data register and then sets the TX request register high
    \item The TX request bit is synchronized into the RX domain
    \item Once the RX request bit is high, the RX data register takes in the value from the TX data register (knowing that the TX data register has been stable for 2 cycles)
    \item The RX request bit is synchronized back to the TX domain as an acknowledge bit
    \item This concludes a data transfer. To prepare for the next transfer, the TX request bit is de-asserted
    \item This will cause the TX acknowledge bit to be de-asserted
    \item The transmitting side is ready for a new data transfer
\end{enumerate}

While this is slower than simply passing data through clock domains, it transmits data reliably.
For this first part, your RISC-V core will handle all of the requests and acknowledges in software through a memory mapped interface detailed below.

\begin{table}[hbt]
  \begin{center}
    \caption{Memory Map for PWM Integration}
    \label{pwm_mmio}
    \begin{tabular}{l l l l}
      \toprule
      \textbf{Address} & \textbf{Function} & \textbf{Access} & \textbf{Data Encoding}\\
      \midrule
      \verb|32'h80000034| & Duty Cycle & Write & \verb|{20'b0, duty_cycle[11:0]}| \\
      \verb|32'h80000038| & TX Request & Write & \verb|{31'b0, tx_req}| \\
      \midrule
      \verb|32'h80000040| & TX Acknowledge & Read & \verb|{31'b0, tx_ack}| \\
      \midrule
    \end{tabular}
  \end{center}
\end{table}

\subsubsection{Implementation}
You can create the PWM controller in its own file.
You can instantiate the PWM controller where you want.

Some code has been provided at the bottom \verb|z1top.v| that declares a wire \verb|pwm_out| which should connect to the output of your PWM controller.
A PLL has been instantiated in \verb|z1top.v| which produces a 150 Mhz clock (\verb|pwm_clk_g|) used for the PWM controller.
There's also a \verb|pwm_rst| signal that can be used to reset the PWM controller.

You should first test the PWM controller using a block-level testbench.
Next try creating a testbench similar to the \verb|echo_integration_testbench| that uses the piano software from the next section.
You will have to load the program into the IMEM and DMEM in simulation and set the \verb|RESET_PC| accordingly (similar to \verb|isa_testbench|).

\subsubsection{Piano Program}
Load the program in \verb|software/square_piano|.
After running \verb|jal 10000000|, you can use the keyboard rows from `c' to `,' and from `q' to `i' to play piano notes.
You can hold down shift to generate upper and lower octaves just like in Lab 6.

This program plays square waves for a fixed note length (1/3rd of a second).
The note length can be adjusted using the buttons:
\begin{itemize}
  \item \verb|buttons[1]| = double note length
  \item \verb|buttons[2]| = halve note length
  \item \verb|buttons[3]| = reset note length to 1/3rd of a second
\end{itemize}

If your processor is running at a frequency other than 50 MHz, regenerate the \verb|scale.h| file. Example below is for 100 MHz.
\begin{minted}{bash}
  cd software/square_piano
  ./piano_scale_generator scale.h 100e6
\end{minted}

\subsection{Subtractive Synth}
While the piano program works, it can only play a single note at a time (monophonic synthesis).
More importantly, it's limited to the CPI of the processor and this in turn limits the waveforms we can send to our DAC.

How could we improve our synthesizer's throughput and implement a polyphonic synthesizer?
Hardware acceleration!
We can implement most of the subtractive synthesis blocks in hardware and lay the groundwork for building a rich sounding synthesizer.
The main datapath that we'll be implementing is shown below:

\begin{center}
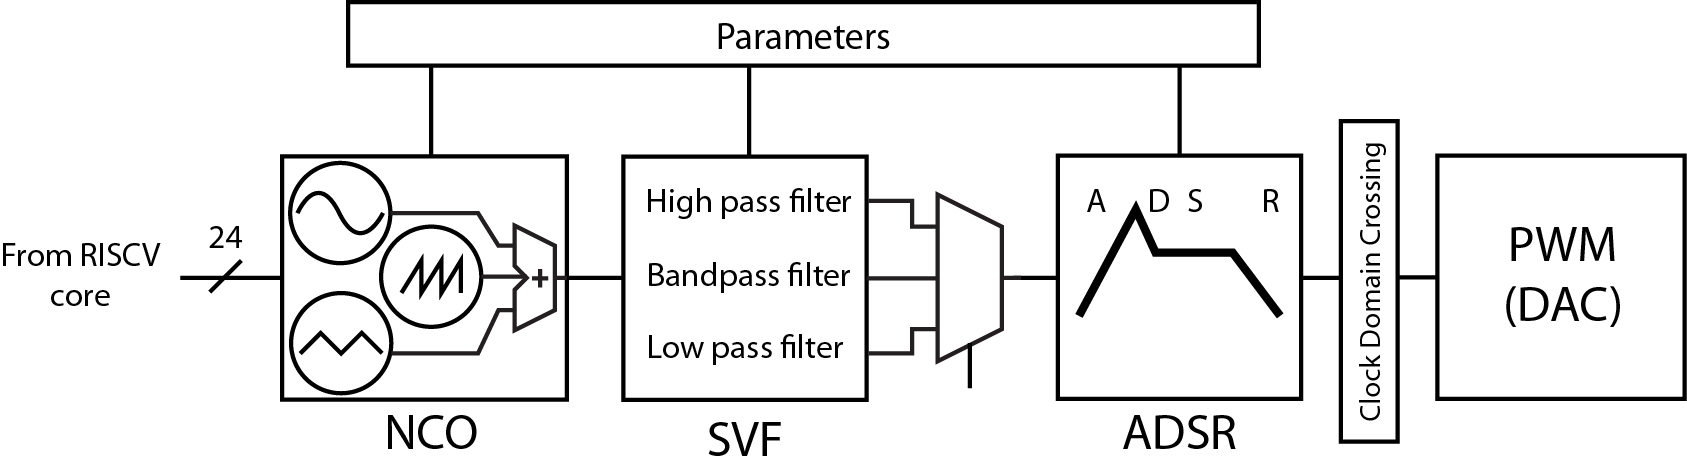
[picture p4: spec/images/ss_dp_1.png]
  
\end{center}

The synthesizer is composed of three blocks:
\begin{enumerate}
  \item Numerically controlled oscillator (NCO). Produces sampled sine, square, triangle, and sawtooth waveforms of programmable frequency. - \textbf{Required}
  \item State variable filter (SVF). A 2nd order digital IIR filter. - \textbf{Optional, Extra Credit}
  \item Amplitude envelope (ADSR - attack, decay, sustain, release) - \textbf{Optional, Extra Credit}
\end{enumerate}

The RISC-V core controls the parameters for each of the blocks using registers that are memory mapped.
A collection of parameter values designed to mimic a particular instrument is called a patch.

The RISC-V core also provides the frequency control word for the NCO, which represents the pitch of a note to play.
Once a note to play is sent to the synthesizer, it will select/sum the appropriate waveforms (from the NCO), filter the samples through the SVF, and apply an ADSR envelope.
The synthesizer should feed samples at the sample rate ($f_{samp}$) to the PWM DAC until the note is released.

This synthesizer is connected to the RISC-V core as shown below.
\begin{center}
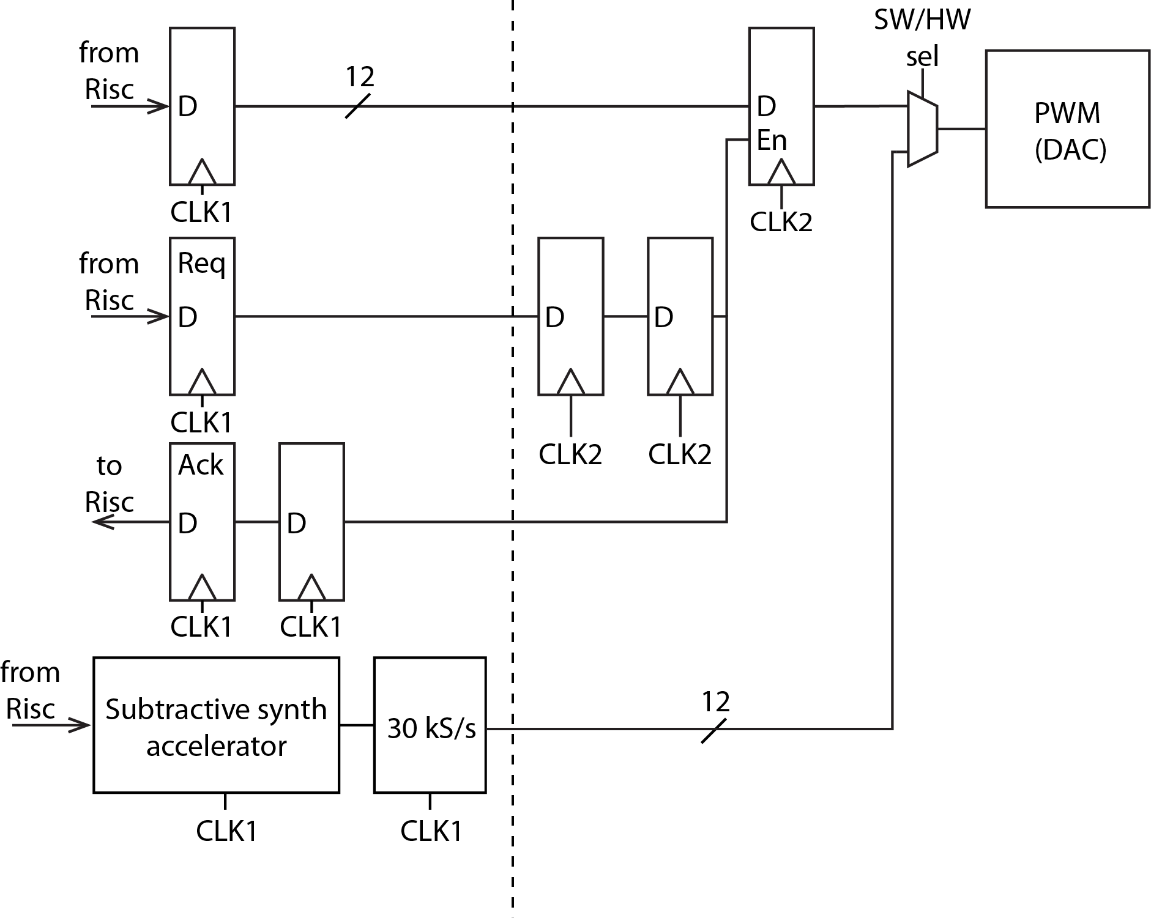
[picture p5: spec/images/fourPhase_2.png]
  
\end{center}

This implements a monophonic synth which can play one note at a time, but we would like to play multiple notes at a time.
To accomplish this, we can replicate the monophonic synth and sum the output of the amplitude envelope blocks as shown in the figure below to produce a polyphonic synth.

\begin{center}
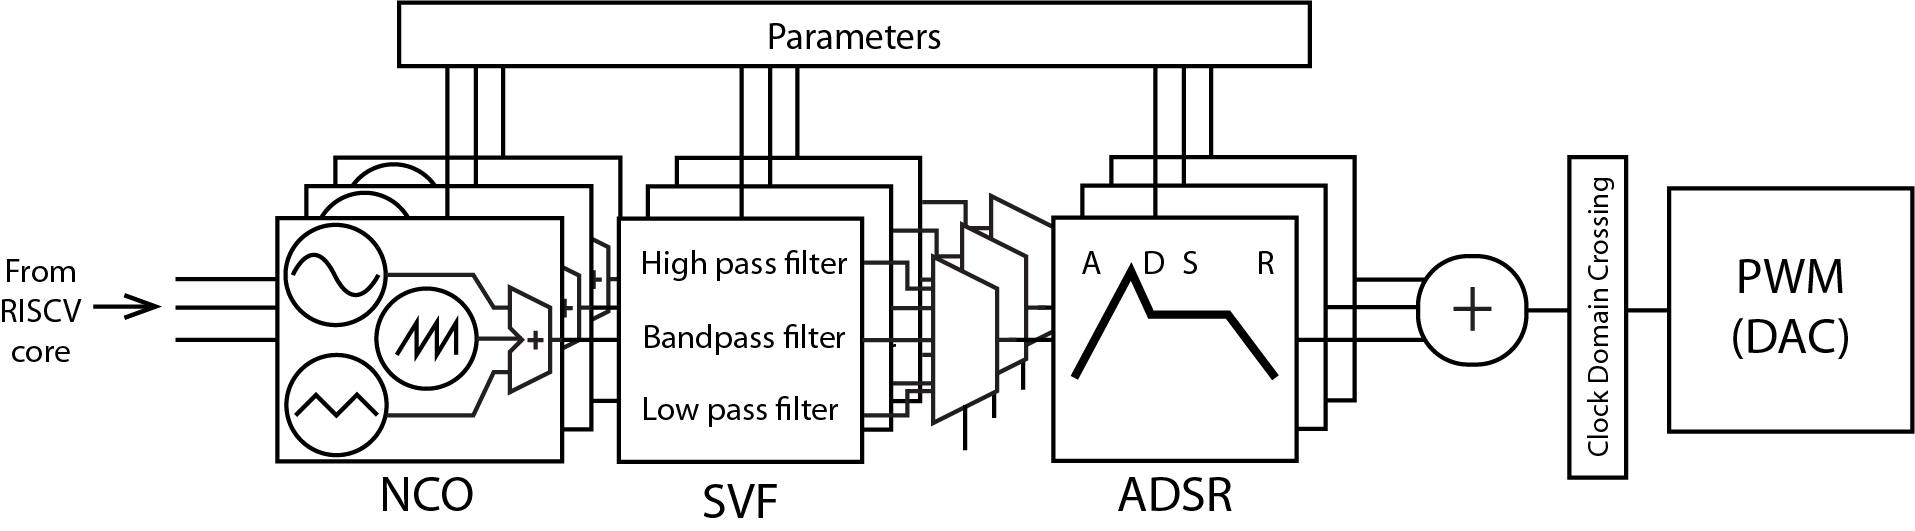
[picture p6: spec/images/ss_dp_2.png]
  
\end{center}

\textbf{A polyphonic synth is required for 251A only}.

\subsubsection{Numerically Controlled Oscillator (NCO) - Required}
We want to generate four waveform types: sine, square, triangle, and sawtooth.
We'll discuss the sine wave generation and you can generalize it to the other waveform types.

\paragraph{NCO Overview}
A continuous time sine wave, with a frequency $f_{sig}$, can be written as:
\begin{equation*}
  f(t) = \sin \left( 2 \pi f_{sig} t \right)
\end{equation*}

If this sine wave is sampled with sampling frequency $f_{samp}$, the resulting stream of discrete time samples is:
\begin{equation*}
  f[n] = \sin \left( 2 \pi f_{sig} \frac{n}{f_{samp}} \right)
\end{equation*}

We want to generate this stream of samples in hardware.
One way to do this is to use a lookup table (LUT) and a phase accumulator (just a register and an adder).
Say we have a LUT that contains sampled points for one period of a sine wave with $2^N$ entries.
The entries $i, 0 \leq i < 2^N$ of this LUT are:
\begin{equation*}
  LUT[i] = \sin \left( i \frac{2 \pi}{2^N} \right)
\end{equation*}

To find the mapping of the sample $n$ to the LUT entry $i$, we can equate the expressions inside $\sin()$:
\begin{align*}
  i \frac{2 \pi}{2^N} &= 2 \pi f_{sig} \frac{n}{f_{samp}} \\
  i &= \underbrace{\left( \frac{f_{sig}}{f_{samp}} 2^N \right)}_{\text{phase increment}} n
\end{align*}

This means that to compute sample $n+1$ we should take the LUT index used for sample $n$ and increment the index by the `phase increment'.
The phase increment (also called the `frequency control word') is written by the RISC-V core into a MMIO register (24-bits wide).

To find the frequency resolution (the minimum frequency step) we can look at what change in $f_{sig}$ causes the phase increment to increase by 1:
\begin{align*}
  \frac{f_{sig} + \Delta_{f,min}}{f_{samp}} 2^N &= \frac{f_{sig}}{f_{samp}} 2^N + 1 \\
  \Delta_{f,min} &= \frac{f_{samp}}{2^N}
\end{align*}

This means for a example sample frequency $f_{samp}$ of 30 kHz and $N = 24$, the frequency resolution is 0.001 Hz.
We can have very precise frequency control using an NCO.

However, a $2^{24}$ entry LUT is huge and wouldn't fit on the FPGA.
So, we will keep the phase accumulator $N$ (24-bits) wide, and only use the MSB $M$ bits to index the sine wave LUT.
This means the LUT only contains $2^M$ entries, where $M$ is chosen based on the required phase error.
We will use $M = 8$.

\begin{figure}
  \centering
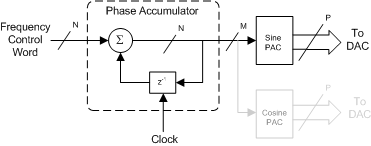
[picture p7: spec/images/Generic_NCO.png]
  
  \caption{NCO architecture from \href{https://en.wikipedia.org/wiki/Numerically-controlled_oscillator}{Wikipedia}}
\end{figure}

\paragraph{Fixed Point Representation of LUT Values}
The values in the sine LUT will be signed numbers representing one period of a sampled sine wave.
They will be stored in a fixed point representation (16 fractional bits, 4 integer bits inclusive of 1 sign bit).
This number representation will be used through the entire synthesizer.

Review \href{http://www-inst.eecs.berkeley.edu/~cs61c/sp06/handout/fixedpt.html}{this 61C handout} for a quick overview of fixed point numbers.

\paragraph{NCO Non-Idealities}
There are three sources of inaccuracy when using an NCO:
\begin{enumerate}
  \item Limited frequency resolution when converting a continuous frequency $f_{sig}$ to the integer frequency control word
  \item Using a smaller LUT ($2^M$ entries) than the phase accumulator width ($2^N$ possible values) can accomodate
  \item Fixed point quantization vs. arbitrary precision representation of the LUT values
\end{enumerate}

The first source of inaccuracy can be handled by choosing a large phase accumulator bit width.
The second source can be alleviated using \textit{interpolation}.
The last source can be handled by using more bits per LUT element at the cost of area.

%% Interpolation
\paragraph{Interpolation}
You can linearly interpolate between the $i$ and $i+1$ LUT index using the residual bits in the phase accumulator.
While the MSB $M$ bits are used to index into the LUT, the LSB $N-M$ bits can be used for interpolation as a residual error.
You should get linear interpolation working after building the basic NCO.

\paragraph{NCO Model}
We've provided a model of the NCO in \verb|scripts/synth/NCO.py|.
You can run these commands.
You can replace \verb|sine| with \verb|square|, \verb|triangle|, or \verb|sawtooth|.
\begin{enumerate}
  \item \verb|./NCO.py --analysis| - Plot NCO samples vs ideal samples from a sine function (to play with how to choose $N$ and $M$ and the effect of interpolation)
  \item \verb|./NCO.py --sine-lut| - Dump the binary representation of the 4 types of LUTs (so they can be used by \verb|$readmemb| in Verilog)
  \item \verb|./NCO.py --sine-plot| - Plot the sine LUT values
  \item \verb|./NCO.py --golden| - Dump the golden sample values for $f_{samp} = 30 \text{kHz}$ and $f_{sig} = 880 \text{Hz}$
\end{enumerate}

You can dump a LUT to a file like: \verb|./NCO.py --triangle-lut > triangle.bin|.

\paragraph{Waveform Summation}
The NCO produces all 4 waveform types per sample.
Another module (the Summer), following the NCO, sums them together after scaling each waveform's sample.
The scaling is done with an arithmetic right shift amount assigned to each waveform type.

\paragraph{Implementation}
The NCO implementation details are up to you.
Note that it is OK to use several clock cycles to generate one sample value, so pipelining is useful for making sure your critical paths are short.
\textbf{We recommend} that the NCO uses a ready/valid interface to produce samples (that are later consumed by the sample buffer).

You can read in a LUT binary using \verb|$readmemb()|:
\begin{minted}{verilog}
reg [x:0] sine_lut [0:y];
`define STRINGIFY_SINELUT(x) `"x/src/audio/sine.bin`"
initial begin
  $readmemb(`STRINGIFY_SINELUT(`ABS_TOP), sine_lut);
end
\end{minted}

The NCO should be hooked up to the RISC-V core via MMIO (Table \ref{nco_mmio}).
\begin{table}[hbt]
  \begin{center}
    \caption{Memory Map for NCO and Summer}
    \label{nco_mmio}
    \begin{tabular}{l l l l}
      \toprule
      \textbf{Address} & \textbf{Function} & \textbf{Access} & \textbf{Data Encoding}\\
      \midrule
      \verb|32'h80000200| & Sine NCO Scale & Write & \verb|{27'd0, sine_shift[4:0]}| \\
      \verb|32'h80000204| & Square NCO Scale & Write & \verb|{27'd0, square_shift[4:0]}| \\
      \verb|32'h80000208| & Triangle NCO Scale & Write & \verb|{27'd0, triangle_shift[4:0]}| \\
      \verb|32'h8000020c| & Sawtooth NCO Scale & Write & \verb|{27'd0, sawtooth_shift[4:0]}| \\
      \midrule
      \verb|32'h80001000| & Frequency Control Word (Voice 1) & Write & \verb|{8'd0, fcw[23:0]}| \\
      \midrule
    \end{tabular}
  \end{center}
\end{table}

\paragraph{Testing}
You should generate golden samples from the \verb|NCO.py| script for various signal frequencies and use a unit-level testbench to verify the NCO produces identical samples.

\subsubsection{Sample Buffer and CDC - Required}
The signal chain we want to implement is below (with the data format of their outputs in parentheses, FixP = signed fixed point).
\begin{align*}
  \text{NCO (4x 16/4 FixP)} &\rightarrow \text{Summer (16/4 FixP)} \rightarrow \text{Global Gain (16/4 FixP)}\\
  &\rightarrow \text{Truncator (12-bit unsigned int)} \rightarrow \text{Buffer + CDC} \rightarrow \text{PWM DAC}
\end{align*}

You implemented the NCO and summer in the previous section.
Now we will implement 4 other blocks:
\begin{enumerate}
  \item \textbf{Global gain}: this is just another arithmetic right shift of the summer output
  \item \textbf{Truncator}: converts a high precision signed fixed-point sample to a 12-bit unsigned integer for the PWM DAC
  \item \textbf{Buffer}: buffers a continuous stream of samples and emits them at a fixed rate of $f_{samp}$
  \item \textbf{CDC}: sends samples from the buffer to the PWM clock domain using a 4-phase handshake
\end{enumerate}

\paragraph{Global Gain and Truncator}
The global gain is an arithmetic right shifter on the output of the Summer.
It is used to limit the volume of the synth.

The global gain block outputs fixed point samples (with 16 fractional bits and 4 integer bits).
But, the PWM DAC takes 12-bit unsigned duty cycle values.
The truncator should take the 12 MSB bits from the global gain block and treat them as a signed number.
Then that number should be converted into the PWM duty cycle value:
\begin{itemize}
  \item $-2^{11}$: duty cycle[11:0] = 0
  \item $0$: duty cycle[11:0] = 2048
  \item $2^{11} - 1$: duty cycle[11:0] = 4095
\end{itemize}

The global gain comes from MMIO (Table \ref{gain_mmio}).
\begin{table}[hbt]
  \begin{center}
    \caption{Memory Map for Gain/Truncator}
    \label{gain_mmio}
    \begin{tabular}{l l l l}
      \toprule
      \textbf{Address} & \textbf{Function} & \textbf{Access} & \textbf{Data Encoding}\\
      \midrule
      \verb|32'h80000104| & Global Gain Shift & Write & \verb|{27'd0, global_gain[4:0]}| \\
      \midrule
    \end{tabular}
  \end{center}
\end{table}

\paragraph{Sample Buffer + CDC}
The NCO continuously produces samples, but now we want to send those samples to the PWM DAC at a fixed rate $f_{samp}$.
Implement a block that rate limits samples from the NCO and sends them to the PWM DAC using the 4-phase CDC handshake.

We've added a MMIO register (PWM DAC Source) (Table \ref{cdc_mmio}) that controls which duty cycle register feeds the PWM block.
This 1-bit register should be synchronized to the PWM clock domain and controls which RX duty-cycle register is fed into the PWM block.
(0 = CPU, 1 = synth)

\begin{table}[hbt]
  \begin{center}
    \caption{Memory Map for Synth CDC}
    \label{cdc_mmio}
    \begin{tabular}{l l l l}
      \toprule
      \textbf{Address} & \textbf{Function} & \textbf{Access} & \textbf{Data Encoding}\\
      \midrule
      \verb|32'h80000044| & PWM DAC Source & Write & \verb|{31'd0, source}| \\
      \midrule
    \end{tabular}
  \end{center}
\end{table}

\paragraph{Synth Integration}
The synth top-level should stitch together the blocks above into a signal chain.
The top-level also contains control signals that the CPU can use to reset the synth (Table \ref{synth_mgmt_mmio}).

The CPU will play notes by performing the following sequence:
\begin{enumerate}
  \item Configure the static parameters of the synth (sine/square/triangle/sawtooth NCO gain, global gain, PWM DAC source)
  \item Write to the global synth reset
  \item To play a particular note:
    \begin{enumerate}
      \item Write the note's FCW to \verb|0x8000_1000|
      \item Write to \verb|0x8000_1004| which should begin sending samples to the PWM DAC
      \item Once the note is released, the CPU writes to \verb|0x8000_1008|, and you should stop sending samples to the PWM DAC
      \item The CPU then polls for \verb|0x8000_100c| to go high, indicating the synth has flushed out all the samples to send
      \item The CPU writes to \verb|0x8000_1010| to clear \verb|note_finished| and any other synth state
    \end{enumerate}
\end{enumerate}

\begin{table}[hbt]
  \begin{center}
    \caption{Memory Map for Synth Management}
    \label{synth_mgmt_mmio}
    \begin{tabular}{l l l l}
      \toprule
      \textbf{Address} & \textbf{Function} & \textbf{Access} & \textbf{Data Encoding}\\
      \midrule
      \verb|32'h80000100| & Global Synth Reset & Write & \verb|NA| \\
      \midrule
      \verb|32'h80001004| & Note Start (Voice 1) & Write & \verb|NA| \\
      \verb|32'h80001008| & Note Release (Voice 1) & Write & \verb|NA| \\
      \verb|32'h8000100c| & Note Finished (Voice 1) & Read & \verb|{31'd0, note_finished}| \\
      \verb|32'h80001010| & Reset (Voice 1) & Write & \verb|NA| \\
      \midrule
    \end{tabular}
  \end{center}
\end{table}

You should simulate this sequence in simulation.

\subsubsection{Synth Model}
We've provided a model of all the blocks above in several Python classes:
\begin{itemize}
  \item \verb|scripts/synth/NCO.py| - the NCO model, outputs all 4 waveform types
  \item \verb|scripts/synth/Blocks.py| - models of the summer and truncator (with global gain)
  \item \verb|scripts/synth/Synth.py| - model of the full mono and poly synths
\end{itemize}

You should use \verb|Synth.py| to dump golden DAC samples for testing in simulation.

\subsubsection{FPGA Testing}

\subsubsection{State Variable Filter (SVF) - Optional}
% For the synth as a whole
%% SVF F coeff
%% SVF Q coeff
%% SVF bypass enable
The SVF is an infinite impulse response (IIR) filter with multiple outputs (as shown below). You will need to define this block diagram in verilog and then put the outputs into a mux that the parameters block will control. It's important to note that $Y_h$ is a high pass filtered output, $Y_b$ is the bandpass filtered output, $Y_n$ is the notch filtered output, and lastly $Y_l$ is the low pass filtered output. For further information (such as how to pick the different values for different corner frequencies) you can refer to this reference: \href{https://karmafx.net/docs/karmafx_digitalfilters.pdf}{SVF reference}

\begin{center}
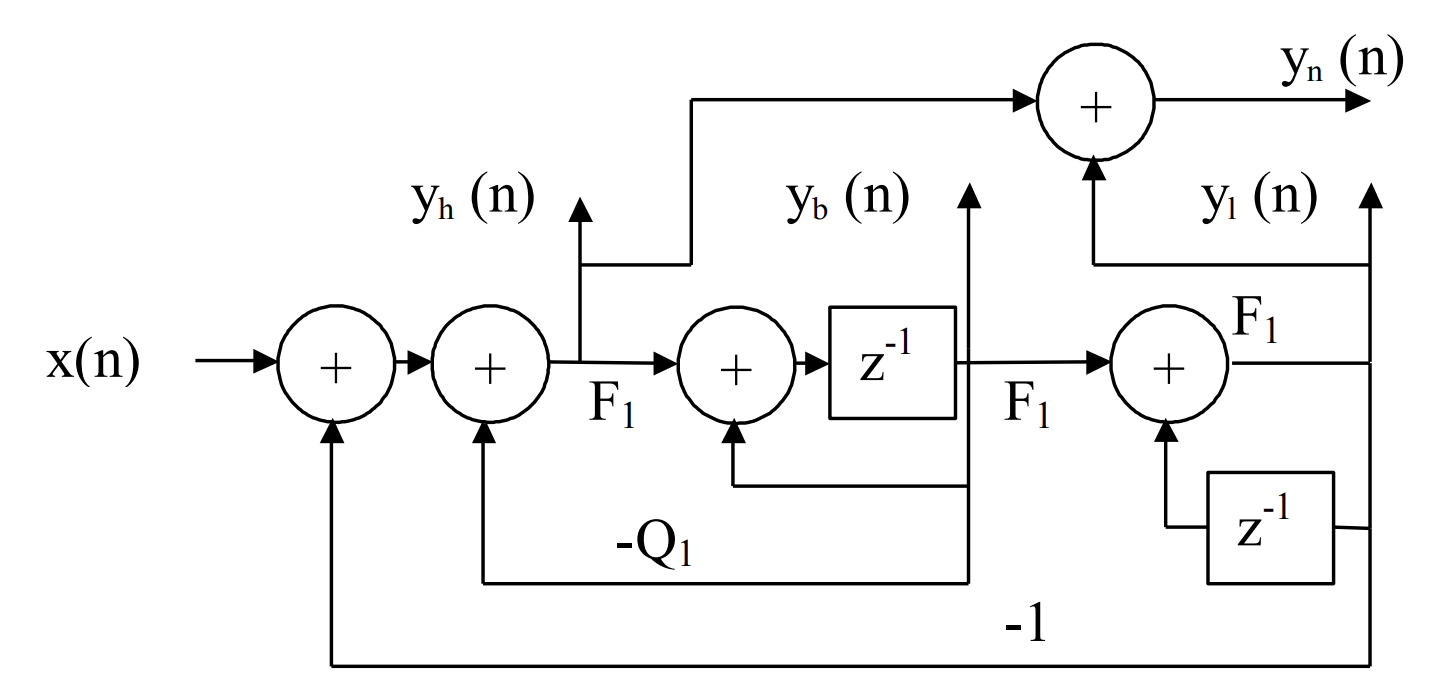
[picture p8: spec/images/svf.png]
  
\end{center}

In scripts/synthesizer.py, a software implementation of the synthesizer has been provided for you. It is important to keep in mind that digital implementation of IIR filters is non-trivial. If not done carefully, you may exceed the available number of bits and encounter overflow problems. In addition, multiplications must be performed by values less than one to make sure the system is bounded. Therefore, in the model provided for you, we implement "fixed point operation", where fractions are represented by binary numbers. For instance, 0.5 is "1", and 0.625 is "101" ($0.5 \times 1 + 0.25 \times 0 + 0.125 \times 1$). Because we do not have values larger than 1, we do not need to separate integer from fraction (unless you decide to set Q to be larger than 1,in which case you will have to handle this). Performing multiplication of fixed point numbers should be the same as performing regular multiplication. However, the sign of the number (MSB) should be taken out and computed separately. In total, you have 24 bits to spare in the SVF registers, Therefore, budget your resolution wisely to not encounter overflow problems. You may change the values of F to change the corner frequency of your filter. The filter should be able to adapt to different corner frequencies at run time.

\subsubsection{Amplitude Envelope (ADSR) - Optional}
%% Envelope attack increment per sample
%% Envelope sustain level (assumed to be 1, so don't define it)
%% Envelope release decrement per sample (assumed floor to be 0)
The ADSR block can be simplified to an "ASR" block. Meaning, you just have an "attack, sustain, and release" process. This block will take the output of the SVF and modulate the amplitude such that the resulting sound will get louder, hold, and get quiet after every key press. This is done by multiplying the waveform out of the SVF filter with scalars. The ADSR should receive a "press" and a "release" signal from the CPU. You can choose the time it takes for attack to go from silent to the largest amplitude. Then the output would sustain its largest level until a "release" signal is received, and after that the sound start decaying to silence again. The python model provided for you generates a reference behavior of the ADSR envelop. You may choose the envelop to mimic any instrument you would like to.

\subsubsection{Polyphonic Synthesis - 251A Only}
To enable polyphony, instantiate multiple synths.
We'll use 4 voice polyphony.
Parameters that have MMIO addresses like \verb|0x8000_01xx| or \verb|0x8000_02xx| are shared among all synths.

Only the note-specific MMIO registers are distinct for each synth (Table \ref{poly_mmio}).
The 3rd nibble of the address distinguishes each synth's note registers.

A polyphonic synth model is in \verb|scripts/synth/Synth.py|.

\begin{table}[hbt]
  \begin{center}
    \caption{Memory Map for Polyphony}
    \label{poly_mmio}
    \begin{tabular}{l l l l}
      \toprule
      \textbf{Address} & \textbf{Function} & \textbf{Access} & \textbf{Data Encoding}\\
      \midrule
      \verb|32'h80002000| & Frequency Control Word (Voice 2) & Write & \verb|{8'd0, fcw[23:0]}| \\
      \verb|32'h80002004| & Note Start (Voice 2) & Write & \verb|NA| \\
      \verb|32'h80002008| & Note Release (Voice 2) & Write & \verb|NA| \\
      \verb|32'h8000200c| & Note Finished (Voice 2) & Read & \verb|{31'd0, note_finished}| \\
      \verb|32'h80002010| & Reset (Voice 2) & Write & \verb|NA| \\
      \midrule
    \end{tabular}
  \end{center}
\end{table}

\textit{Coming:} software

\subsection{Checkpoint 3 Deliverables Summary}
\begin{center}
  \begin{tabular}{m{30mm} m{35mm} m{70mm}}
    \toprule
    \textbf{Deliverable} & \textbf{Due Date} & \textbf{Description} \\
    \midrule
    User I/Os + PWM Piano + Synth & \audioDueDate & Demonstrate the working user IO test, and PWM piano programs. Describe the design of your synth and produce various sounds.\\
    \bottomrule
  \end{tabular}
\end{center}

\iffalse
\section{\dfsTaskName: Power Management Unit with Dynamic Frequency Scaling}
\subsection{Checkpoint 4 Deliverables Summary}
\begin{center}
  \begin{tabular}{m{30mm} m{35mm} m{70mm}}
    \toprule
    \textbf{Deliverable} & \textbf{Due Date} & \textbf{Description} \\
    \midrule
    PMU Core + power management program & \dfsDueDate & Demonstrate keeping the FPGA temperature below X\degree C while executing an intensive \verb|mmult| in less than X seconds.\\
    \bottomrule
  \end{tabular}
\end{center}
\fi

\pagebreak

\section{Final Checkpoint - Optimization}
This optimization checkpoint is lumped with the final checkoff.
This part of the project is designed to give students freedom to implement the optimizations of their choosing to improve the performance of their processor.

The optimization goal for this project is to minimize the \textbf{execution time} on the \verb|mmult| program, as defined by the 'Iron Law' of Processor Performance.

\begin{equation*}
\frac{\text{Time}}{\text{Program}} = \frac{\text{Instructions}}{\text{Program}} \times \frac{\text{Cycles}}{\text{Instruction}} \times \frac{\text{Time}}{\text{Cycle}}
\end{equation*}

The number of instructions is fixed, but you have freedom to change the CPI and the CPU clock frequency.
Often you will find that you will have to sacrifice CPI to achieve a higher clock frequency, but there also will exist opportunities to improve one or both of the variables without compromises.

\subsection{Grading on Optimization}
You will be \textbf{primarily} graded on trying several design points (tradeoffs between CPI and clock frequency), documenting your results, and achieving the best \verb|mmult| performance.
You must demonstrate a working CPU at an optimized clock frequency (above 50MHz) that has a working BIOS, can load and execute programs (both echo and mmult), can receive, process, and send to user I/O, and has a working audio synthesizer.

A \textbf{very minor} component of the optimization grade is based total FPGA resource utilization, with the best designs using as few resources as possible.
Credit for your area optimizations will be calculated using a cost function.
At a high level, the cost function will look like:
\begin{equation*}
\mathrm{Cost}=\mathrm{C_{LUT}} \times \text{\# of LUTs} + \mathrm{C_{RAMB}} \times \text{\# of RAMBs} + \mathrm{C_{REG}} \times \text{\# of Slice Registers}
\end{equation*}
where $\mathrm{C_{LUT}}$, $\mathrm{C_{RAMB}}$, and $\mathrm{C_{REG}}$ are constant value weights that will be decided upon based on how much each resource that you use should cost. As part of your final grade we will evaluate the cost of your design based on this metric. Keep in mind that cost is only one very small component of your project grade. Correct functionality is far more important.

\subsection{Clock Generation Info + Changing Clock Frequency}
Open up \verb|z1top.v|.
There's top level input called \verb|CLK_125MHZ_FPGA|.
It's a 125 MHz clock signal, which is used to derive the CPU clock.

Scrolling down, there's an instantiation of \verb|PLLE2_ADV|, which is a PLL (phase locked loop) primitive on the FPGA.
This is a circuit that can create a new clock from an existing clock with a user-specified multiply-divide ratio.

The \verb|CLKIN1| input clock of the PLL is driven by the 125 MHz \verb|CLK_125MHZ_FPGA|.
The frequency of \verb|CLKOUT0| is calculated as:
\begin{equation*}
  \mathtt{CLKOUT0}_f = \mathtt{CLKIN1}_f \cdot \frac{\mathtt{CLKFBOUT\_MULT}}{\mathtt{DIVCLK\_DIVIDE} \cdot \mathtt{CLKOUT0\_DIVIDE}}
\end{equation*}

In our case we get:
\begin{equation*}
  \mathtt{CLKOUT0}_f = 125 \text{ MHz} \cdot \frac{34}{5 \cdot 17} = 50 \text{ MHz}
\end{equation*}

Table \ref{pll_params} specifies the ideal PLL parameters to get certain output frequencies.

\begin{table}[hbt]
  \begin{center}
    \caption{PLL Parameters}
    \label{pll_params}
    \begin{tabular}{l l l l}
      \toprule
      Frequency & \verb|DIVCLK_DIVIDE| & \verb|CLKFBOUT_MULT| & \verb|CLKOUT0_DIVIDE|\\
      \midrule
      50 MHz & 5 & 34 & 17 \\
      60 MHz & 5 & 36 & 15 \\
      65 MHz & 5 & 39 & 15 \\
      70 MHz & 5 & 42 & 15 \\
      75 MHz & 5 & 33 & 11 \\
      80 MHz & 5 & 48 & 15 \\
      85 MHz & 5 & 34 & 10 \\
      90 MHz & 5 & 36 & 10 \\
      95 MHz & 5 & 38 & 10 \\
      100 MHz & 5 & 36 & 9 \\
      \bottomrule
    \end{tabular}
  \end{center}
\end{table}

\subsection{Critical Path Identification}
After running \verb|make impl|, timing analysis will be performed to determine the critical path(s) of your design.
The timing tools will automatically figure out the CPU's clock timing constraint based on the multiply-divide ratio you used in your PLL.

The critical path can be found by looking in \verb|build/impl/post_route_timing_summary.rpt|.
Look for the paths within your CPU (\verb|From Clock: cpu_clk, To Clock: cpu_clk|).

For each timing path look for the attribute called ``slack''.
Slack describes how much extra time the combinational delay of the path has before the rising edge of the receiving clock.
It is a setup time attribute.
Positive slack means that this timing path resolves and settles before the rising edge of the clock, and negative slack indicates a setup time violation.

There are some common delay types that you will encounter.
\verb|LUT| delays are combinational delays through a LUT.
\verb|net| delays are from wiring delays. They come with a fanout attribute which you should aim to minimize.
Notice that your logic paths are usually dominated by routing delay; as you optimize, you should reach the point where the routing and LUT delays are about equal portions of the total path delay.

\subsubsection{Schematic View}
To visualize the path, you can open Vivado (\verb|make vivado|), and open a DCP (Design Checkpoint) file (\verb|File| $\rightarrow$ \verb|Checkpoint| $\rightarrow$ \verb|Open|).
The DCP is in \verb|build/impl/z1top_routed.dcp|.

Re-run timing analysis with \verb|Reports| $\rightarrow$ \verb|Timing| $\rightarrow$ \verb|Report Timing Summary|.
Use the default options and click \verb|OK|.
Navigate (on the bottom left) to \verb|Intra-Clock Paths| $\rightarrow$ \verb|cpu_clk| $\rightarrow$ \verb|Setup|.

You can double-click any path to see the logic elements along it, or you can right-click and select \verb|Schematic| to see a schematic view of the path.
These post-PNR timing reports may be hard to decipher, so it may help to look at the post-synth DCP in \verb|build/synth/z1top.dcp|.

You can also use the \href{https://www.xilinx.com/support/answers/54778.html}{\texttt{keep\_hierarchy} attribute} to prevent Vivado from moving registers and logic across module boundaries.

\begin{minted}{verilog}
// in z1top.v
(* keep_hierarchy="yes" *) Riscv151 #( ) cpu ( );
\end{minted}

\subsubsection{Finding Actual Critical Paths}
When you first check the timing report with a 50 MHz clock, you might not see your 'actual' critical path.
50 MHz is easy to meet and the tools will only attempt to optimize routing until timing is met, and will then stop.

You should increase the clock frequency slowly and rerun \verb|make impl| until you fail to meet timing.
At this point, the critical paths you see in the report are the 'actual' ones you need to work on.

Don't try to increase the clock speed up all the way to 100 MHz initially, since that will cause the routing tool to give up even before it tried anything.

\subsection{Optimization Tips}
%As you work on achieving a higher clock speed, you will likely notice that the routing tool (PAR) is quite temperamental. You may find that your design might meet timing for a given clock speed, but after making a small, insignificant design change, the tool fails to meet timing. This is because PAR uses a random seed as a starting point in its algorithm. Sometimes it is a 'good' seed and yields an optimal result, but a small design change may cause the same seed to become 'bad' for that design and it yields a sub-optimal result.

As you optimize your design, you will want to try running \verb|mmult| on your newly optimized designs as you go along. You don't want to make a lot of changes to your processor, get a better clock speed, and then find out you broke something along the way.

You will find that sacrificing CPI for a better clock speed is a good bet to make in some cases, but will worsen performance in others.
You should keep a record of all the different optimizations you tried and the effect they had on CPI and minimum clock period; this will be useful for the final report when you have to justify your optimization and architecture decisions.

There is no limit to what you can do in this section.
The only restriction is that you have to run the original, unmodified \verb|mmult| program so that the number of instructions remain fixed.
You can add as many pipeline stages as you want, stall as much or as little as desired, add a branch predictor, or perform any other optimizations.
If you decide to do a more advanced optimization (like a 5 stage pipeline), ask the staff to see if you can use it as extra credit in addition to the optimization.

You will be graded based on the best \verb|mmult| performance you were able to achieve, but \textit{more critically} on how many design points you explored.
Keep notes of your architecture modifications in the process of optimization.
Consider, but don't obsess, over area usage when optimizing (keep records though).

\pagebreak

\section{Grading and Extra Credit}
\textbf{All groups must complete the final checkoff by \finalCheckoffDueDate.}
If you are unable to make the deadline for any of the checkpoints, it is still in your best interest to complete the design late, as you can still receive most of the credit if you get a working design by the final checkoff.

\subsection{Checkpoints}
\label{checkoff}
We have divided the project up into checkpoints so that you (and the staff) can pace your progress.
The due dates are indicated at the end of each checkpoint section, as well as in the \textbf{Project Timeline} (Section \ref{project_timeline}) at the end of this document.

\subsection{Style: Organization, Design}
\label{style}
Your code should be modular, well documented, and consistently styled.
Projects with incomprehensible code will upset the graders.

\subsection{Final Project Report}
Upon completing the project, you will be required to submit a report detailing the progress of your EECS151/251A project.
The report should document your final circuit at a high level, and describe the design process that led you to your implementation.
We expect you to document and justify any tradeoffs you have made throughout the semester, as well as any pitfalls and lessons learned.
Additionally, you will document any optimizations made to your system, the system's performance in terms of area (resource use), clock period, and CPI, and other information that sets your project apart from other submissions.

The staff emphasizes the importance of the project report because it is the product you are able to take with you after completing the course.
All of your hard work should reflect in the project report.
Employers may (and have) ask to examine your EECS151/251A project report during interviews.
Put effort into this document and be proud of the results.
You may consider the report to be your medal for surviving EECS151/251A.

\subsubsection{Report Details}
You will turn in your project report on Gradescope by the final checkoff date.
The report should be around 8 pages total with around 5 pages of text and 3 pages of figures ($\pm$ a few pages on each).
Ideally you should mix the text and figures together.

Here is a suggested outline and page breakdown for your report.
You do not need to strictly follow this outline, it is here just to give you an idea of what we will be looking for.

\begin{itemize}
  \item \textbf{Project Functional Description and Design Requirements}. Describe the design objectives of your project.  You don't need to go into details about the RISC-V ISA, but you need to describe the high-level design parameters (pipeline structure, memory hierarchy, etc.) for this version of the RISC-V. ($\approx$ 0.5 page)
  \item \textbf{High-level organization}. How is your project broken down into pieces. Block diagram level-description. We are most interested in how you broke the CPU datapath and control
  down into submodules, since the code for the later checkpoints will be pretty consistent across all groups. Please include an updated block diagram ($\approx$ 1 page).
  \item \textbf{Detailed Description of Sub-pieces}. Describe how your circuits work. Concentrate here on novel or non-standard circuits. Also, focus your attention on the parts of the design that were not supplied to you by the teaching staff. For instance, describe the details of your FIFOs, audio synthesizer, and any extra credit work. ($\approx$ 2 pages).
  \item \textbf{Status and Results}. What is working and what is not? At what frequency (50MHz or greater) does your design run? Do certain checkpoints work at a higher clock speed while others only run at 50 MHz? Please also provide the number of LUTs and SLICE registers used by your design, which can be found by running \verb|make report|. Also include the CPI and minimum clock period of running \verb|mmult| for the various optimizations you made to your processor. This section is particularly important for non-working designs (to help us assign partial credit). ($\approx$ 1-2 pages).
  \item \textbf{Conclusions}. What have you learned from this experience? How would you do it different next time? ($\approx$ 0.5 page).
  \item \textbf{Division of Labor. This section is mandatory. Each team member will turn in a separate document from this part only}. The submission for this document will also be on Gradescope. How did you organize yourselves as a team. Exactly who did what? Did both partners contribute equally? Please note your team number next to your name at the top. ($\approx$ 0.5 page).
\end{itemize}

When we grade your report, we will grade for clarity, organization, and grammar.
Submit your report to the Gradescope assignment.
Only one partner needs to submit the shared report, while each individual will need to submit the division of labor report to a separate Gradescope assignment.

\subsection{Extra Credit}
\label{extra_credit}
Teams that have completed the base set of requirements are eligible to receive extra credit worth up to 10\% of the project grade by adding extra functionality and demonstrating it at the time of the final checkoff.

The following are suggested projects that may or may not be feasible in one week.
\begin{itemize}
  \item Branch Predictor: Implement a two bit (or more complicated) branch predictor with a branch history table (BHT) to replace the naive 'always taken' predictor used in the project
  \item 5-Stage Pipeline: Add more pipeline stages and push the clock frequency past 100MHz
  \item Audio Recording: Capture mic input from the Pynq's microphone and wire it to the CPU via MMIO
  \item RISC-V M Extension: Extend the processor with a hardware multiplier and divider
\end{itemize}

When the time is right, if you are interested in implementing any of these, see the staff for more details.

\subsection{Project Grading}
\label{deadlinegrading}

\begin{description}
  \item[80\%] {Functionality} at project due date. You will demonstrate the functionality of your processor during the final interview.
  \item[5\%] {Optimization} at project due date. This score is contingent on implementing all the required functionality. An incomplete project will receive a zero in this category.
  \item[5\%] {Checkpoint} functionality. You are graded on functionality for each completed checkpoint. The total of these scores makes up 5\% of your project grade. The weight of each checkpoint's score may vary.
  \item[10\%] {Final report} and {style} demonstrated throughout the project.
\end{description}

Not included in the above tabulations are point assignments for extra credit as discussed above. Extra credit is discussed below:

\begin{description}
  \item[Up to 10\%] Additional functionality. Credit based on additional functionality will be qualified on a case by case basis. Students interested in expanding the functionality of their project must meet with a GSI well ahead of time to be qualified for extra credit. Point value will be decided by the course staff on a case by case basis, and will depend on the complexity of your proposal, the creativity of your idea, and relevance to the material taught.
\end{description}

\section{Project Timeline}
\label{project_timeline}

\begin{table}[h!]
  \centering
  \begin{center}
  \begin{tabular}{l l l}
    \toprule
    {Checkpoint} &{Deliverable} & {Due Date} \\
    \midrule
    1 \& 2: RISCV151 Processor & Design Review &  \blockDiagramDueDate\\
     & In-Lab Checkoff & \baseCPUDueDate \\
    \midrule
    3: IOs, FIFOs, PWM Controller, Synth & In-Lab Checkoff &  \audioDueDate \\
     & Project Interview & \\
    \midrule
    Final Checkoff, Extra Credit, &    In-Lab Checkoff        & \finalCheckoffDueDate \\
    and Optimizations             & Github code submission    &  \\
    \midrule
    Final Report                  &   Gradescope submission     & \finalReportDueDate \\
    \bottomrule
  \end{tabular}
  \end{center}
\caption{EECS151 \currentSemester \space Project Timeline}\label{tab:master}
\end{table}

\newpage

\appendix
\section{Local Development}
You can build the project on your laptop but there are a few dependencies to install.
In addition to Vivado and Icarus Verilog, you need a RISC-V GCC cross compiler and an \verb|elf2hex| utility.

\subsection{Linux}
A system package provides the RISC-V GCC toolchain (Ubuntu): \verb|sudo apt install gcc-riscv64-linux-gnu|.
There are packages for other distros too.

To install \verb|elf2hex|:
\begin{minted}{bash}
git clone git@github.com:sifive/elf2hex.git
cd elf2hex
autoreconf -i
./configure --target=riscv64-linux-gnu
make
vim elf2hex # Edit line 7 to remove 'unknown'
sudo make install
\end{minted}

\subsection{OSX, Windows}
Download SiFive's GNU Embedded Toolchain \href{https://www.sifive.com/boards}{from here}.
See the 'Prebuilt RISC-V GCC Toolchain and Emulator' section.

After downloading and extracting the tarball, add the \verb|bin| folder to your \verb|PATH|.
For Windows, make sure you can execute \verb|riscv64-unknown-elf-gcc -v| in a Cygwin terminal.
Do the same for OSX, using the regular terminal.

For Windows, re-run the Cygwin installer and install the packages\\\verb|git, python3, python2, autoconf, automake, libtool|.
See \href{https://stackoverflow.com/questions/47168311/cygwin-and-failed-to-run-aclocal-no-such-file-or-directory}{this StackOverflow question} if you need help selecting the exact packages to install.

Clone the \verb|elf2hex| repo \verb|git clone git@github.com:sifive/elf2hex|.
Follow the instructions in the \href{https://github.com/sifive/elf2hex}{elf2hex repo README} to build it from git.
You should be able to run \verb|riscv64-unknown-elf-elf2hex| in a terminal.

\section{BIOS}
\label{sec:biosinfo}
This section was written by Vincent Lee, Ian Juch, and Albert Magyar.

\subsection{Background}
For the first checkpoint we have provided you a BIOS written in C that your processor is
instantiated with. BIOS stands for Basic Input/Output System and forms the bare bones of the
CPU system on initial boot up. The primary function of the BIOS is to locate, and initialize the
system and peripheral devices essential to the PC operation such as memories, hard drives, and
the CPU cores.

Once these systems are online, the BIOS locates a boot loader that initializes the operating
system loading process and passes control to it. For our project, we do not have to worry about
loading the BIOS since the FPGA eliminates that problem for us. Furthermore, we will not deal
too much with boot loaders, peripheral initialization, and device drivers as that is beyond the
scope of this class. The BIOS for our project will simply allow you to get a taste of how the
software and hardware layers come together.

The reason why we instantiate the memory with the BIOS is to avoid the problem of
bootstrapping the memory which is required on most computer systems today. Throughout the
next few checkpoints we will be adding new memory mapped hardware that our BIOS will
interface with. This document is intended to explain the BIOS for checkpoint 1 and how it
interfaces with the hardware. In addition, this document will provide you pointers if you wish to
modify the BIOS at any point in the project.

\subsection{Loading the BIOS}
For the first checkpoint, the BIOS is loaded into the Instruction memory when you first build it.
As shown in the Checkpoint 1 specification, this is made possible by instantiating your
instruction memory to the BIOS file by building the block RAM with the \verb|bios151v3.hex| file. If you
want to instantiate a modified BIOS you will have to change this .hex file in your block RAM
directory and rebuild your design and the memory.

To do this, simply cd to the \verb|software/bios151v3| directory and make the .hex file by running
“make”. This should generate the .hex file using the compiler tailored to our ISA. The
block RAM will be instantiated with the contents of the .hex file.
When you get your design to synthesize and impact to the board, open up screen using the
same command from Lab 5:

\verb|screen $SERIALTTY 115200|

Once you are in \verb|screen|, if you CPU design is working correctly you should be able to hit Enter
and a carrot prompt \verb|'>'| will show up on the screen. If this doesn’t work, try hitting the reset
button on the FPGA which is the center compass switch and hit enter. If you can’t get the BIOS
carrot to come up, then your design is not working and you will have to fix it.

\subsection{Loading Your Own Programs}
The BIOS that we provide you is written so that you can actually load your own programs for
testing purposes and benchmarking. Once you instantiate your BIOS block RAM with the
\verb|bios151v3.hex| file and synthesize your design, you can transfer your own program files over the
serial line.

To load you own programs into the memory, you need to first have the .hex file for the program
compiled. You can do this by copying the software directory of one of our C programs folders in
/software directory and editing the files. You can write your own MIPS program by writing
test code to the .s file or write your own c code by modifying the .c file.
Once you have the .hex file for your program, impact your board with your design and run:

\verb|hex_to_serial <file name> <target address>|

The \verb|<file name>| field corresponds to the .hex file that you are to uploading to the instruction
memory. The \verb|<target address>| field corresponds to the location in memory you want to write
your program to.

Once you have uploaded the file, you can fire up screen and run the command:

\verb|jal <target hex address>|

Where the \verb|<target hex address>| is where you stored the location of the hex file over
serial. Note that our design does not implement memory protection so try to avoid storing your
program over your BIOS memory. Also note that the instruction memory size for the first
checkpoint is limited in address size so large programs may fail to load.
The jal command will change the PC to where your program is stored in the instruction
memory.

\subsection{The BIOS Program}
The BIOS itself is a fairly simple program and composes of a glorified infinite loop that waits for
user input. If you open the \verb|bios151v3.c| file, you will see that the main method composes of a
large for loop that prints a prompt and gets user input by calling the \verb|read_token| method.
If at any time your program execution or BIOS hangs or behaves unexpected, you can hit the
reset button on your board to reset the program execution to the main method.
The \verb|read_token| method continuously polls the UART for user input from the keyboard until it
sees the character specified by ds. In the case of the BIOS, the termination character
\verb|read_token| is called with is the 0xd character which corresponds to Enter.
The \verb|read_token| method will then return the values that it received from the user. Note that
there is no backspace option so if you make a mistake you will have to wait until the next
command to fix it.

\begin{figure}[H]
  \centering
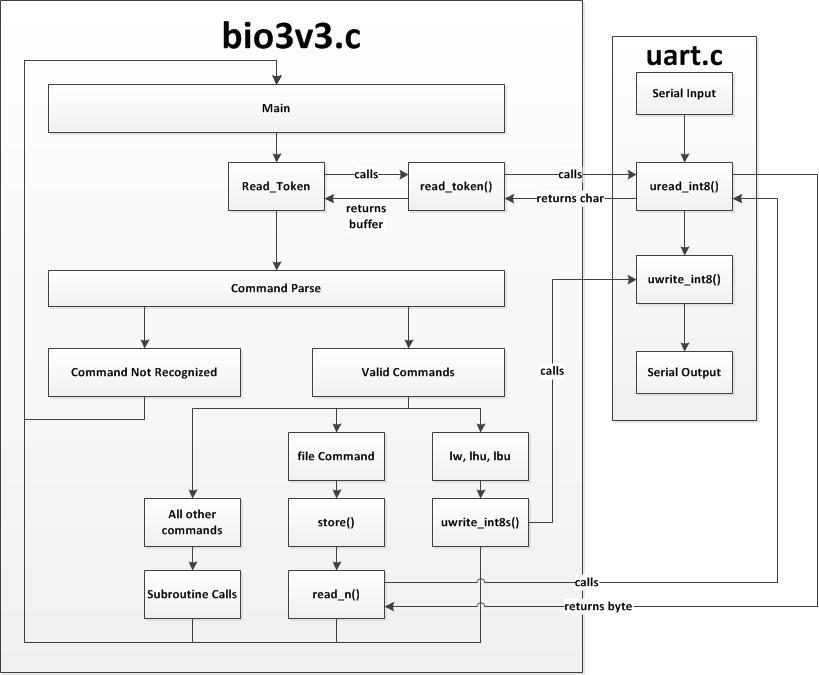
[picture p9: spec/images/bios_flow.png]
  
  \caption{BIOS Execution Flow}
\end{figure}

The buffer returned from the \verb|read_token| method with the user input is then parsed by
comparing the returned buffer against commands that the BIOS recognizes. If the BIOS parses a
command successfully it will execute the appropriate subroutine or commands. Otherwise it
will tell you that the command you input is not recognized.
If you want to add commands to the BIOS at any time in the project, you will have to add to the
comparisons that follow after the \verb|read_token| subroutine in the BIOS.

\subsection{The UART}
You will notice that some of the BIOS execution calls will call subroutines in the uart.c file
which takes care of the transmission and reception of byte over the serial line.
The uart.c file contains three subroutines. The first subroutine, \verb|uwrite_int8| executes a
UART transmission for a single byte by writing to the output data register. The second
subroutine \verb|uwrite_int8s| allows you to process an array of type \verb|int8_t| or chars and send
them over the serial line. The third routine \verb|uread_int8| polls the UART for valid data and
reads a byte from the serial line.

In essence, these three routines are operating the UART on your design from a software view
using the memory mapped I/O. Therefore, in order for the software to operate the memory
map correctly, the \verb|uart.c| module must store and load from the correct addresses as defined
by out memory map. You will find the necessary memory map addresses in the uart.h file that
conforms to the design specification.

\subsection{Command List}
The following commands are built into the BIOS that we provide for you. All values are
interpreted in hexadecimal and do not require any radix prefix (ex. ``0x''). Note that there is not
backspace command.

\verb|jal <hexadecimal address>| - Moves program execution to the specified address

\verb|lw <hexadecimal address>| - Displays word at specified address to screen

\verb|lhu <hexadecimal address>| - Displays half at specified address to screen

\verb|lbu <hexadecimal address>| - Displays byte at specified address to screen

\verb|sw <value> <hexadecimal address>| - Stores specified word to address in memory

\verb|sh <value> <hexadecimal address>| - Stores specified half to address in memory

\verb|sb <value> <hexadecimal address>| - Stores specified byte to address in memory

There is another command file in the main() method that is used only when you execute
\verb|hex_to_serial|. When you execute \verb|hex_to_serial|, your workstation will initiate a byte
transfer by calling this command in the BIOS. Therefore, don’t mess with this command too
much as it is one of the more critical components of your BIOS.

\subsection{Adding Your Own Features}
Feel free to modify the BIOS code if you want to add your own features during the project for
fun or to make your life easier. If you do choose to modify the BIOS, make sure to preserve
essential functionality such as the I/O and the ability to store programs. In order to add
features, you can either add to the code in the \verb|bios151v3.c| file or create your own c source and
header files. Note that you do not have access to standard c libraries so you will have to add
them yourself if you need additional library functionality.
\end{document}

% ARCHIVE
%\subsubsection{Music Streamer in Software}
%Now that we have access to user I/Os and access to the tone generator, we can fully implement the music streamer and sequencer FSM from lab 4 entirely in software!
%
%The music streamer program can be found in \verb|software/music_streamer|. To use this program, use the same scripts from Lab 3 to generate a music data file from a MusicXML file, and then convert that data file to a static array declaration that can be used in a C program.
%
%\begin{minted}[frame=single]{bash}
%python scripts/musicxml_parser.py musicxml/Row_Row_Row_Your_Boat.mxl music.txt
%\end{minted}
%
%You will now have a \verb|music.txt| file in the \verb|/software/music_streamer| directory with the music data. Now we use the \verb|c_array_generator.py| script to create a static array declaration using this file.
%
%\begin{minted}[frame=single]{bash}
%python scripts/c_array_generator.py music.h music.txt
%\end{minted}
%
%Now, we have a file called \verb|music.h| that has a static array declaration filled with the music data. This serves exactly the same purpose as the ROM that was generated in Lab 3.
%
%To build the \verb|music_streamer| program and place it on your processor, execute:
%\begin{minted}[frame=single]{bash}
%make
%hex_to_serial music_streamer.hex 3000a000
%screen $SERIALTTY 115200
%151> jal 1000a000
%\end{minted}
%
%The \verb|music_streamer| functions exactly like it does in Lab 3, but the state machine that was implemented directly in hardware, is now implemented in software. Here is the state machine diagram for reference:
%
%\begin{center}
%  \begin{tikzpicture}[shorten >=1pt, node distance=10cm,on grid, auto, semithick]
%  \tikzstyle{state} = [draw, very thick, fill=white, rectangle, minimum height=3em, minimum width=7em, node distance=12em, font={\sffamily\bfseries}]
%  \tikzstyle{stateEdgePortion} = [black,thick];
%  \tikzstyle{stateEdge} = [stateEdgePortion,->];
%  \tikzstyle{edgeLabel} = [pos=0.5, text centered, font={\sffamily\small}];
%
%  \node[state,initial](rp) {REGULAR\_PLAY};
%  \node[state](revp) [below =of rp]{REVERSE\_PLAY};
%  \node[state](p) [right=of rp]{PAUSED};
%  \node[state](playseq) [above=of rp]{PLAY\_SEQ};
%  \node[state](editseq) [left=of rp]{EDIT\_SEQ};
%
%  \path[->]
%  (playseq) edge node [swap] {play\_pause} (p)
%  edge node [swap] {switch\_mode} (editseq)
%  edge node {} (rp)
%  (editseq) edge node {} (playseq)
%  (rp) edge node {play\_pause} (p)
%  edge [swap] node {switch\_mode} (revp)
%  edge node {switch\_fn} (playseq)
%  (p) edge node {} (rp)
%  edge [bend right, swap] node {switch\_fn} (playseq)
%  (revp) edge [swap] node {play\_pause} (p)
%  edge [swap] node {} (rp);
%  \end{tikzpicture}
%\end{center}
%
%The program will print out information as you transition the state machine, edit notes in the sequencer, and modify the tempo.
