darklyght/RISC-V-on-Zynq-7000/spec/images/aud_pwm.png

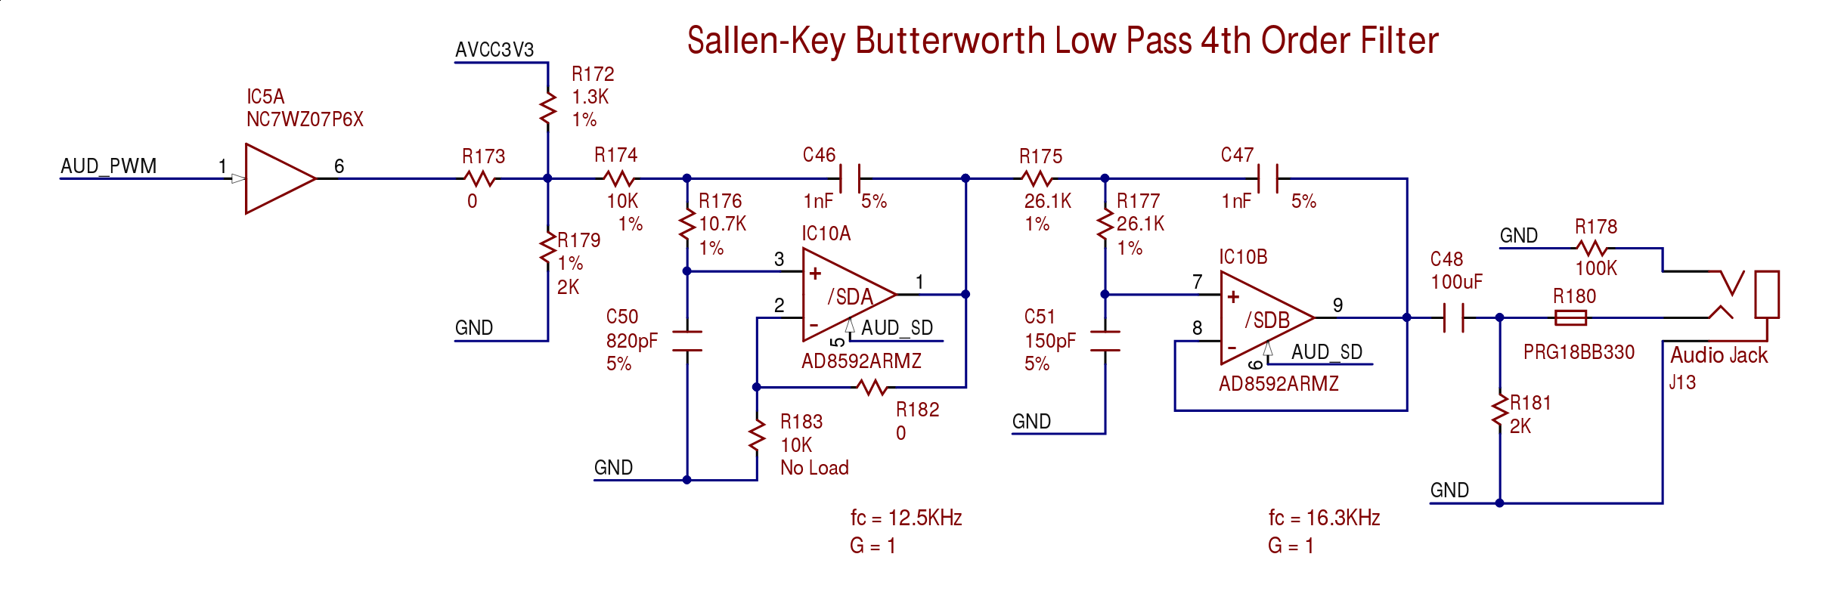
spec/images/aud_pwm.png
