darklyght/RISC-V-on-Zynq-7000/spec/images/RISCMemoryArchitectureBigMemLarge.jpg

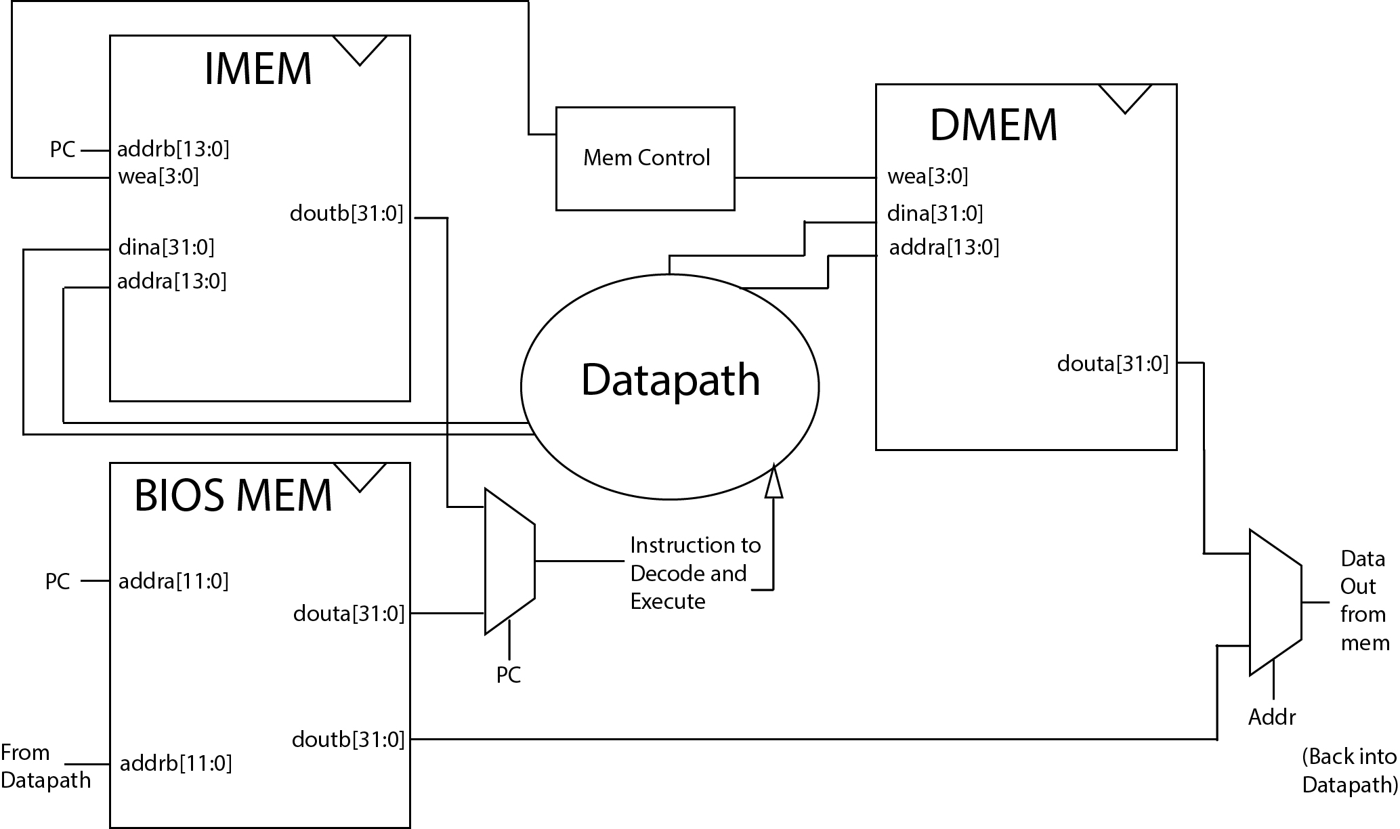
spec/images/RISCMemoryArchitectureBigMemLarge.jpg
