darklyght/RISC-V-on-Zynq-7000/spec/images/riscv151overview.png

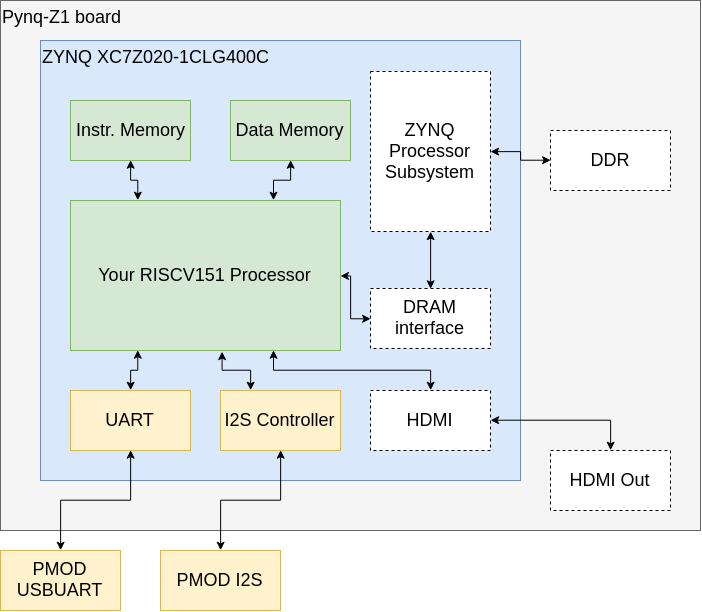
spec/images/riscv151overview.png
