darklyght/RISC-V-on-Zynq-7000/spec/images/ss_dp_0.png

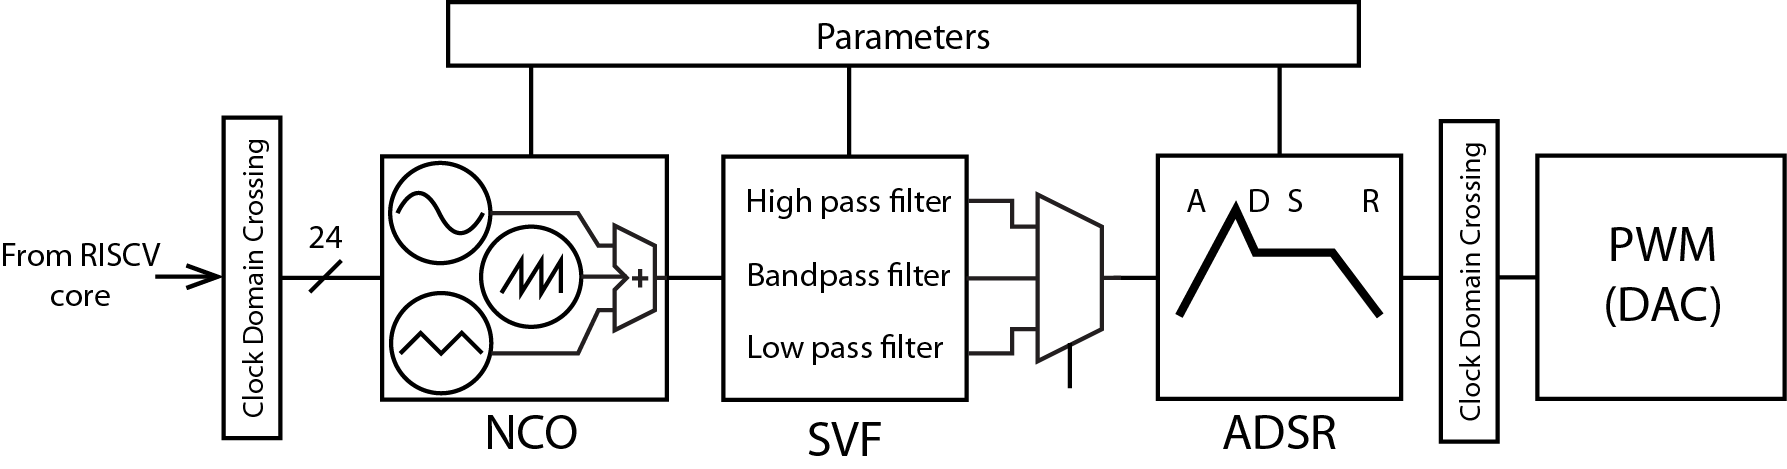
spec/images/ss_dp_0.png
