darklyght/RISC-V-on-Zynq-7000/hardware/stubs/PLLE2_ADV.v

`timescale 1 ps / 1 ps

`celldefine

module PLLE2_ADV #(
`ifdef XIL_TIMING
  parameter LOC = "UNPLACED",
  parameter real CLKIN_FREQ_MAX = 1066.000,
  parameter real CLKIN_FREQ_MIN = 19.000,
  parameter real CLKPFD_FREQ_MAX = 550.0,
  parameter real CLKPFD_FREQ_MIN = 19.0,
  parameter real VCOCLK_FREQ_MAX = 2133.000,
  parameter real VCOCLK_FREQ_MIN = 800.000,
`endif
  parameter BANDWIDTH = "OPTIMIZED",
  parameter integer CLKFBOUT_MULT = 5,
  parameter real CLKFBOUT_PHASE = 0.000,
  parameter real CLKIN1_PERIOD = 0.000,
  parameter real CLKIN2_PERIOD = 0.000,
  parameter integer CLKOUT0_DIVIDE = 1,
  parameter real CLKOUT0_DUTY_CYCLE = 0.500,
  parameter real CLKOUT0_PHASE = 0.000,
  parameter integer CLKOUT1_DIVIDE = 1,
  parameter real CLKOUT1_DUTY_CYCLE = 0.500,
  parameter real CLKOUT1_PHASE = 0.000,
  parameter integer CLKOUT2_DIVIDE = 1,
  parameter real CLKOUT2_DUTY_CYCLE = 0.500,
  parameter real CLKOUT2_PHASE = 0.000,
  parameter integer CLKOUT3_DIVIDE = 1,
  parameter real CLKOUT3_DUTY_CYCLE = 0.500,
  parameter real CLKOUT3_PHASE = 0.000,
  parameter integer CLKOUT4_DIVIDE = 1,
  parameter real CLKOUT4_DUTY_CYCLE = 0.500,
  parameter real CLKOUT4_PHASE = 0.000,
  parameter integer CLKOUT5_DIVIDE = 1,
  parameter real CLKOUT5_DUTY_CYCLE = 0.500,
  parameter real CLKOUT5_PHASE = 0.000,
  parameter COMPENSATION = "ZHOLD",
  parameter integer DIVCLK_DIVIDE = 1,
  parameter [0:0] IS_CLKINSEL_INVERTED = 1'b0,
  parameter [0:0] IS_PWRDWN_INVERTED = 1'b0,
  parameter [0:0] IS_RST_INVERTED = 1'b0,
  parameter real REF_JITTER1 = 0.010,
  parameter real REF_JITTER2 = 0.010,
  parameter STARTUP_WAIT = "FALSE"
)(
  output CLKFBOUT,
  output CLKOUT0,
  output CLKOUT1,
  output CLKOUT2,
  output CLKOUT3,
  output CLKOUT4,
  output CLKOUT5,
  output [15:0] DO,
  output DRDY,
  output LOCKED,

  input CLKFBIN,
  input CLKIN1,
  input CLKIN2,
  input CLKINSEL,
  input [6:0] DADDR,
  input DCLK,
  input DEN,
  input [15:0] DI,
  input DWE,
  input PWRDWN,
  input RST
);

endmodule
