darklyght/RISC-V-on-Zynq-7000/hardware/sim/svf_testbench.v

`timescale 1ns/1ps
module svf_testbench ();
    
    reg clk;
    reg rst;
    reg [11:0] F;
    reg [11:0] Q;
    reg [11:0] x;
    reg en_in;
    wire [11:0] yh;
    wire [11:0] yb;
    wire [11:0] yl;
    wire [11:0] yn;
    
    integer inputs;
    
    svf dut (
        .clk(clk),
        .rst(rst),
        .en_in(en_in),
        .F(F),
        .Q(Q),
        .x(x),
        .yh(yh),
        .yb(yb),
        .yl(yl),
        .yn(yn)
    );
    
    initial clk = 0;
    always #5 clk = ~clk;
        
    initial begin
        `ifndef IVERILOG
            $vcdpluson;
        `endif
        `ifdef IVERILOG
            $dumpfile("svf_testbench.fst");
            $dumpvars(0, svf_testbench);
        `endif
        
        inputs = $fopen("../../scripts/waves.bin","r");
        
        rst = 1;
        en_in = 1;
        F = 12'b0100_0000_0000;
        Q = 12'b0101_1010_1000;
        x = 12'b0;
        repeat(5) @(posedge clk);
        rst = 0;
        repeat(5) @(posedge clk);
        while (!$feof(inputs)) begin
            $fscanf(inputs,"%b\n", x); #1;
            @(posedge clk);
        end
        $finish();
    end
    
endmodule
