darklyght/RISC-V-on-Zynq-7000/(commit log)

2019-11-02 fix iverilog typ warnings, use buttons[0] for reset
    [z1top.v]
2019-11-09 Use relative path for assembly_testbench
2019-11-09 Passes basic assembly test
2019-11-09 Passes UART echo test
2019-11-11 Working BIOS UART
2019-11-11 Add buttons
2019-11-17 alu bugs/alu testbench/reg testbench
    [alu.v, alu_testbench.v, reg_testbench.v]
2019-11-18 dmem_wsel bugs / testbench
    [dmem_wsel_testbench.v]
2019-11-20 add IOB registers for uart signals
2019-11-25 fix iverilog simulation warnings, better timeouts
    [assembly_testbench.v, echo_integration_testbench.v, echo_testbench.v, isa_testbench.v]
2019-11-27 square piano program for use with pwm dac
2019-11-28 Add assembly_pwm_testbench and bug fixes
    [assembly_pwm_testbench.v, dmem_wsel.v]
2019-12-01 Fix IIR stability issues
    [adsr.v, nco.v, phase_accumulator.v, sawtooth_generator.py, sawtooth_lut.v, sine_generator.py, sine_lut.v, square_wave.v]
2019-12-03 cleanup sample buffer + cdc part, polyphony part, modeling
2019-12-08 Mini fix in preparation for clock frequency increase
    [Riscv151.v]
